gomez-92/BioSoft/docs/manual-de-usuario.docx

# BioSoft

Manual de usuario — sistema de exposición controlada a campos electromagnéticos de frecuencia extremadamente baja para experimentación con animales de laboratorio.

Destinatario: operador y personal técnico del equipo · Versión 2, septiembre de 2026 · Estado: equipo en desarrollo

El presente documento describe la operación del sistema BioSoft: su arquitectura, el cableado de sus componentes, el procedimiento de configuración y ejecución de una exposición, la interpretación de la información que presenta la interfaz y las acciones recomendadas ante condiciones anómalas.

Está dirigido a dos lectores. El operador encontrará en las secciones 5 a 16 lo necesario para conducir un experimento sin conocimientos de programación. El personal técnico que deba abrir el gabinete, verificar una conexión o reemplazar un componente encontrará en las secciones 3 y 4 la descripción completa del cableado, con la asignación de cada pin y un procedimiento de comprobación. En ambos casos resulta indispensable comprender qué magnitudes mide el equipo y bajo qué criterios interrumpe la exposición, dado que de ello depende la validez de los resultados experimentales.

Advertencia preliminar

BioSoft se encuentra en desarrollo. La sección 15 enumera los aspectos que aún no están calibrados, montados o accesibles desde la interfaz. Su lectura es obligatoria antes de emplear el equipo con animales, puesto que condiciona qué diseños experimentales son válidos en el estado actual.

# 1. Objeto del equipo

BioSoft expone una muestra de animales de laboratorio a un campo electromagnético de frecuencia extremadamente baja (ELF) de intensidad y frecuencia controladas, sostenido durante un tiempo definido, mientras verifica de forma continua que las condiciones de la exposición se mantengan dentro de los márgenes admitidos por el protocolo experimental.

Sus funciones son tres, y conviene distinguirlas:

1. Generación del campo: una señal senoidal de la frecuencia seleccionada, con la intensidad de consigna, aplicada sobre hasta cuatro bobinas.
2. Medición en tiempo real de la intensidad de campo, la temperatura y la corriente.
3. Interrupción de la exposición cuando corresponde: por cumplimiento de la duración programada, por detección de una condición peligrosa o por decisión del operador.

La tercera función es la que justifica el sistema. La generación de un campo es un problema resuelto; lo que un experimento con animales exige es que la decisión de detener la exposición no dependa de la presencia de una persona.

## Los dos grupos experimentales

El diseño experimental requiere un grupo tratado y un grupo control. El equipo lo resuelve mediante dos modos de experimento:

Campo X — Las cuatro bobinas contribuyen en fase. Es la condición de exposición.

Campo nulo — Dos de las bobinas reciben la señal invertida 180°, de modo que los campos se cancelan. Los animales del grupo control quedan sometidos al mismo ruido, vibración y temperatura del equipo en funcionamiento, pero sin campo neto.

El campo nulo es lo que hace comparable al grupo control. Un control obtenido apagando el equipo mediría el efecto de permanecer en un recinto distinto, no el efecto del campo.

# 2. Arquitectura del sistema

El sistema está compuesto por dos placas de propósito distinto, unidas por un enlace serie, más los transductores, actuadores y la etapa de potencia que excita las bobinas.

Componente | Función
Interfaz hombre-máquina (HMI) | Placa ESP32 con pantalla táctil de 2,8". Presenta el estado, permite configurar el experimento y publica telemetría por WiFi.
Placa de control | Arduino Mega 2560. Excita las bobinas, lee los sensores y decide cuándo interrumpir la exposición.
Bobinas (hasta 4) | Generan el campo. Se agrupan en dos pares de fase: 1-3 (fija) y 2-4 (invertible).
Sensores | Un magnetómetro, un termómetro y hasta cuatro sensores de corriente.
Etapa de potencia | Acondiciona la señal senoidal, la invierte para el campo nulo, le aplica la amplitud y la entrega a las bobinas.
Interruptor general | Relé que corta la alimentación de toda la etapa de potencia.
Pulsador de emergencia | Corte físico inmediato del experimento en curso.
Tarjeta SD | Archivo de configuración del equipo (sección 14).

La autoridad sobre la seguridad reside en la placa de control, no en la interfaz. Si la pantalla se bloquea o se desconecta, la placa de control continúa vigilando y conserva la capacidad de cortar. La interfaz refleja y retransmite el estado; no lo decide.

Esta separación tiene una consecuencia operativa: cuando el enlace entre ambas placas se interrumpe, la interfaz vuelve a la pantalla de inicio, pero un experimento en curso no se detiene por ese motivo. La placa de control lo lleva a término, lo corta por sus propias reglas o responde al pulsador de emergencia, todo ello sin necesidad de la pantalla.

# 3. Cableado del sistema

Esta sección documenta cómo está conectado el sistema, pin por pin, tal como lo configura el firmware vigente. Su propósito es que quien abra el gabinete pueda identificar cada conexión, comprobarla contra esta referencia y reponerla si fue desconectada. Los números de pin son los serigrafiados en cada placa; las direcciones I2C son las que el firmware espera encontrar en el bus.

Alcance

Se documenta aquí lo que las placas de control e interfaz entregan y reciben: señales lógicas, buses y transductores. La etapa de potencia (amplificación, inversor, filtrado y alimentación de las bobinas) constituye una frontera cuyo diseño eléctrico se describe en docs/coil-excitation.md y cuyo montaje está pendiente (sección 15). Las bobinas están caracterizadas en un trabajo previo cuyos datos no se incorporan en este manual.

## 3.1 Vista general

┌───────────────────────────┐ enlace serie 9600 8N1 ┌───────────────────────────────┐
│ HMI · ESP32 (JC2432W328C) │ │ CONTROL · Arduino Mega 2560 │
│ │ GPIO22 (TX2) ──► RX1 (19) │ │
│ pantalla ST7789 (HSPI) │ GPIO35 (RX2) ◄── TX1 (18) │ I2C SDA 20 / SCL 21 │
│ táctil CST816S (I2C) │ GND ───────────── GND │ ├─ MLX90393 0x0C campo │
│ ranura SD (VSPI) │ │ ├─ ADS1115 0x48 corriente│
│ WiFi → MQTT (telemetría) │ │ └─ ADS1115 0x49 corriente│
└───────────────────────────┘ │ OneWire pin 2 ─ DS18B20 TEMP1 │
│ SPI 50/51/52 + CS 5 ─ AD9833 │
│ A0 ─ magnetómetro simulado │
┌────────────────────────────────────────────────────┐ │ │
│ ETAPA DE POTENCIA (fuera del firmware) │ │ PWM 44/45/46/6 ─► intensidad │
│ │◄─┤ EN 23/24/25/26 ─► habilitar │
│ senoidal ─► directa ─────────────► bobinas 1 y 3 │◄─┤ 22 ─► selector de modo (mux) │
│ └► inversor ─► mux ─────► bobinas 2 y 4 │◄─┤ 3 ─► relé general (act. bajo)│
│ PWM ─► filtro RC ─► nivel DC ─► amplitud │ │ 4 ◄─ pulsador de emergencia │
└────────────────────────────────────────────────────┘ └───────────────────────────────┘

Figura 1. Diagrama de bloques del sistema con los pines que utiliza cada interfaz.

## 3.2 Placa de control: asignación de pines

Tabla completa de los pines del Mega 2560 que el firmware configura. «Sentido» se indica desde el punto de vista de la placa.

Pin | Función | Sentido | Observaciones
2 | Bus OneWire — termómetro DS18B20 (TEMP1) | bidireccional | Requiere resistencia de pull-up de 4,7 kΩ entre la línea de datos y +5 V. Solo se atiende el sensor con código ROM 28 3F E5 57 04 E1 3D ED.
3 | Relé del interruptor general | salida | Activo en alto: HIGH = relé cerrado = etapa de potencia habilitada. LOW, pin desconectado o placa sin alimentación = relé abierto. El driver del relé lleva pull-down en su entrada. Al arrancar queda en LOW (abierto).
4 | Pulsador de emergencia | entrada | Pull-up interno activado: el pulsador conecta el pin a GND al presionarse. Contacto normalmente abierto. Antirrebote de 30 ms por software.
5 | FSYNC (chip select) del generador AD9833 | salida | Junto con el bus SPI de hardware (pines 50-52).
6 | PWM de intensidad — bobina 4 (BOB4) | salida | Timer4, 3906 Hz. Asignación provisoria: confirmar contra el ruteo de la placa.
18 | TX1 — enlace serie hacia la HMI | salida | Va al GPIO35 (RX2) del ESP32. Ver 3.3.
19 | RX1 — enlace serie desde la HMI | entrada | Viene del GPIO22 (TX2) del ESP32.
20 | SDA — bus I2C | bidireccional | Magnetómetro MLX90393 y módulos ADS1115. Pull-ups provistos por los módulos.
21 | SCL — bus I2C | salida | Ídem.
22 | Selector de modo de experimento (mux de fase) | salida | HIGH = campo nulo, LOW = campo X. La polaridad está fijada en firmware como provisoria hasta confirmar el cableado del multiplexor.
23 | Habilitación — bobina 1 (BOB1) | salida | Activo en alto: HIGH = bobina habilitada; LOW o desconectado = cortada. Entrada digital a la etapa de estado sólido, con pull-down del lado de la etapa.
24 | Habilitación — bobina 2 (BOB2) | salida | Ídem.
25 | Habilitación — bobina 3 (BOB3) | salida | Ídem. Canal declarado, no registrado por defecto.
26 | Habilitación — bobina 4 (BOB4) | salida | Ídem. Canal declarado, no registrado por defecto.
44 | PWM de intensidad — bobina 1 (BOB1) | salida | Timer5, 3906 Hz, 8 bits.
45 | PWM de intensidad — bobina 2 (BOB2) | salida | Timer5, 3906 Hz.
46 | PWM de intensidad — bobina 3 (BOB3) | salida | Timer5, 3906 Hz.
50 | MISO — bus SPI | entrada | No utilizado por el AD9833 (solo escritura), pero forma parte del bus.
51 | MOSI — bus SPI (SDATA del AD9833) | salida
52 | SCK — bus SPI (SCLK del AD9833) | salida
A0 | Magnetómetro simulado (tensión analógica) | entrada | 0–5 V se mapean linealmente a 0–3 mT. Solo para banco; si queda sin conectar, la lectura es ruido.
USB | Consola de depuración | — | 115200 baudios. Es la vía de diagnóstico de la sección 4.

Los pines 2, 3 y 5 comparten el Timer3 y, por estar ocupados, dejan ese temporizador fuera del uso como PWM. Los pines 4 y 13 (Timer0) y 9 y 10 (Timer2) están excluidos deliberadamente del PWM de intensidad: el primero es la base de tiempo de millis() y de todas las tareas periódicas del firmware; el segundo tiene una tabla de divisores distinta. De ahí que los cuatro canales de intensidad se ubiquen en Timer5 (44, 45, 46) y Timer4 (6).

## 3.3 Enlace serie entre placas

Las dos placas se comunican por un UART de hardware a 9600 baudios, 8N1, con un protocolo de tramas propio (STX, longitud, JSON, CRC-8, ETX). La conexión es cruzada y requiere masa común:

ESP32 (HMI) | Mega 2560 (control)
GPIO22 — TX2 | pin 19 — RX1
GPIO35 — RX2 | pin 18 — TX1
GND | GND

Niveles lógicos

El Mega 2560 trabaja a 5 V y el ESP32 a 3,3 V. La rama TX1 (Mega) → GPIO35 (ESP32) entrega 5 V a una entrada de 3,3 V y debe pasar por un adaptador de nivel o un divisor resistivo. La rama inversa (3,3 V hacia una entrada del Mega) es directa. El firmware no puede verificar la presencia de ese adaptador; forma parte de la comprobación física de la sección 4.

La vitalidad del enlace se comprueba con un intercambio periódico ping/pong cada 2 s. Mientras no haya respuesta, la interfaz permanece en la pantalla de inicio.

## 3.4 Bus I2C de la placa de control

Tres dispositivos comparten el bus (SDA 20, SCL 21). Al arrancar, el firmware recorre las 127 direcciones posibles y registra en la consola cuáles responden, lo que permite distinguir un bus muerto (cableado o alimentación) de un dispositivo en una dirección distinta de la esperada.

Dirección | Dispositivo | Observaciones
0x0C | MLX90393 — magnetómetro (CEM1) | Dirección por defecto del módulo (pines de dirección a masa). Es un dispositivo de 3,3 V: alimentar según lo que admita el módulo utilizado.
0x48 | ADS1115 n.° 1 — corriente, canales SCT013-1 y SCT013-2 | Pin ADDR a GND.
0x49 | ADS1115 n.° 2 — corriente, canales SCT013-3 y SCT013-4 | Pin ADDR a VDD. Declarado en firmware; no existe físicamente todavía.

## 3.5 Sensores

Magnetómetro (CEM1). Un único MLX90393 por I2C. Es el sensor que cierra el lazo de intensidad, por lo que su posición respecto de las bobinas forma parte de la calibración: si se desplaza, los factores de corrección dejan de ser válidos. El firmware conserva un segundo magnetómetro simulado, que lee una tensión en A0, y el archivo de configuración decide cuál de los dos está activo. El simulado no guarda relación física con el campo real y solo sirve para ensayar el firmware en banco.

Termómetro (TEMP1). Un DS18B20 sobre bus OneWire en el pin 2, alimentado a 5 V, con pull-up de 4,7 kΩ en la línea de datos. El firmware direcciona el sensor por su código ROM de 64 bits; si se reemplaza la unidad física por otra, la dirección compilada no coincidirá y la lectura será −127 °C, que el firmware descarta como inválida sin indicar por qué. Reemplazar el sensor implica actualizar TEMP1_ADDRESS en SoftMega2560.ino.

Corriente (SCT013-1 a 4). Transformadores de corriente SCT-013 leídos por conversores ADS1115 en modo diferencial. Cada ADS1115 ofrece solo dos pares diferenciales: el canal 0 corresponde a AIN0–AIN1 y el canal 1 a AIN2–AIN3. Por ello los cuatro canales del gabinete requieren dos módulos. Solo SCT013-1 (módulo 0x48, canal 0) está cableado y habilitado por defecto. La frecuencia de muestreo y la ganancia son registros del módulo, comunes a sus dos canales.

## 3.6 Cadena de excitación de las bobinas

La forma de onda y la amplitud viajan por caminos separados y se combinan en la etapa de potencia:

┌─► directa ─────────────────────► bobinas 1 y 3 (grupo fijo)
AD9833 ──► senoidal ────┤
(SPI, CS 5) └─► inversor (op-amp) ──┐
├─ mux ──► bobinas 2 y 4 (invertible)
(directa) ──────────────┘ ▲
│
pin 22 ── selector de modo

pin 44/45/46/6 ──► PWM 3906 Hz ──► filtro RC ──► nivel DC ──► amplitud de la senoidal
pin 23/24/25/26 ──► habilitación individual de cada bobina
pin 3 ──► relé general ──► alimentación de toda la etapa (conector GND / VDD / enable)

Figura 2. Cadena de señal desde la placa de control hasta las bobinas.

- El AD9833 produce una única senoidal de bajo nivel con componente continua, a la frecuencia del experimento. No es apta para atacar una bobina directamente y requiere acondicionamiento (centrado y ganancia).
- La inversión de fase para el campo nulo es analógica (op-amp inversor + multiplexor), no por software. Se descartó un segundo generador con fase programada porque dos osciladores independientes derivan entre sí y la cancelación se perdería a los pocos minutos sin síntoma alguno (docs/adr/001-inversion-de-fase.md).
- Los grupos de fase son alternados (1-3 y 2-4), no contiguos. De este modo, con solo dos bobinas consecutivas montadas (BOB1 y BOB2, el registro por defecto) ya es posible ejercitar ambos modos.
- El PWM a 3906 Hz, filtrado a un nivel de continua, fija la amplitud de la senoidal. El firmware nunca trocea la senoidal con el PWM: la bobina recibe una señal continua cuya amplitud es la variable de control.
- La habilitación por bobina y el relé general son cortes independientes: el primero decide qué bobinas participan, el segundo corta toda la etapa.

## 3.7 Interfaz HMI: placa ESP32 y periféricos

La interfaz es una placa integrada de la familia «CYD» (2,8", 240×320). Existen dos revisiones incompatibles y el firmware debe compilarse para la que esté instalada:

Revisión | Identificación | Panel | Táctil
ESP32-2432S028R | Un solo conector micro-USB | ILI9341 | Resistivo XPT2046, por SPI propio (VSPI: CLK 25, MOSI 32, MISO 39, CS 33, IRQ 36)
JC2432W328C (Guition) — instalada | micro-USB + USB-C; modelo impreso al dorso | ST7789 (requiere inversión de color) | Capacitivo CST816S, por I2C (SDA 33, SCL 32, RST 25, INT 21, dirección 0x15)

Ambos táctiles ocupan los mismos GPIO, de modo que no es posible distinguirlos por software. Con la configuración de la revisión R en una placa C los colores aparecen invertidos y se registra un toque permanente en una esquina. El cambio de placa exige modificar conjuntamente TOUCH_KIND en display.hpp y TFT_INVERSION_ON en platformio.ini.

GPIO | Función | Bus | Observaciones
2 | TFT — DC (datos/comando) | HSPI
12 | TFT — MISO | HSPI
13 | TFT — MOSI | HSPI
14 | TFT — SCLK | HSPI | 55 MHz.
15 | TFT — CS | HSPI
21 | Táctil — INT | — | No se utiliza (el táctil se lee por sondeo), pero el CST816S maneja la línea: no debe usarse para otra función.
27 | TFT — retroiluminación | — | En la revisión R era el GPIO21 y el 27 quedaba libre para el enlace serie; en la C el 27 es la retroiluminación.
22 | UART2 — TX (hacia RX1 del Mega) | UART2
35 | UART2 — RX (desde TX1 del Mega) | UART2 | GPIO solo de entrada. Entrada de 3,3 V: ver 3.3.
32 | Táctil — SCL | I2C | CST816S en 0x15.
33 | Táctil — SDA | I2C
25 | Táctil — RST | —
5 | Ranura SD — CS | VSPI
18 | Ranura SD — SCLK | VSPI | La SD no comparte el bus de la pantalla.
19 | Ranura SD — MISO | VSPI
23 | Ranura SD — MOSI | VSPI
USB | Consola de depuración | — | 115200 baudios.

La conectividad remota (WiFi y MQTT sobre TLS) no requiere cableado: las credenciales residen en esp32/include/secrets.h, un archivo excluido del repositorio que debe crearse a partir de secrets.example.h antes de compilar.

## 3.8 Interruptor general y pulsador

El interruptor general es un relé mecánico gobernado por el pin 3 de la placa de control, con lógica activa en bajo. Del lado de la potencia se presenta como un conector de tres contactos (GND, VDD, habilitación) que corta la alimentación de toda la etapa. El relé incorpora una protección por software que ignora cambios de estado separados por menos de 200 ms, con el fin de no maltratar el contacto mecánico.

El pulsador de emergencia es un contacto normalmente abierto entre el pin 4 y GND, con pull-up interno. Se detecta por flanco, con antirrebote de 30 ms, y solo tiene efecto durante un experimento en curso (sección 11).

# 4. Verificación del cableado

Procedimiento para comprobar el estado de las conexiones cuando se abre el gabinete, se sospecha de un contacto defectuoso o se reemplaza un componente. Consta de una inspección sin tensión y de una verificación con el equipo encendido, apoyada en la consola de depuración de cada placa. Ambas placas emiten un registro por su puerto USB a 115200 baudios que puede leerse con cualquier monitor serie.

## 4.1 Inspección sin tensión

4. Masa común. Continuidad entre el GND del Mega, el GND del ESP32 y el GND de la etapa de potencia.
5. Enlace serie. Continuidad pin 18 (Mega) → adaptador de nivel → GPIO35 (ESP32); y GPIO22 (ESP32) → pin 19 (Mega). Confirmar que las líneas están cruzadas (TX con RX) y no en paralelo.
6. Bus I2C. Continuidad de SDA (pin 20) y SCL (pin 21) hasta cada módulo. Verificar el pin ADDR de cada ADS1115: a GND en el módulo 0x48, a VDD en el 0x49.
7. Termómetro. Línea de datos al pin 2, resistencia de 4,7 kΩ entre datos y +5 V, alimentación 5 V y GND.
8. AD9833. SDATA al pin 51, SCLK al pin 52, FSYNC al pin 5, alimentación y GND.
9. Salidas hacia la etapa de potencia. PWM (44, 45, 46, 6), habilitaciones (23, 24, 25, 26), selector de modo (22) y relé (3), cada una en su entrada correspondiente. Un PWM conectado a la habilitación de otra bobina, o viceversa, no genera error alguno en el firmware.
10. Pulsador. Continuidad entre pin 4 y GND únicamente con el pulsador accionado.
11. Magnetómetro. Fijación mecánica en la posición registrada en la calibración.

## 4.2 Verificación con el equipo encendido

Con el monitor serie conectado al Mega, la secuencia de arranque informa el estado de cada bus. Lo que debe observarse:

Registro en consola | Significado | Si no aparece
[I2C] Dispositivo encontrado en 0xC, 0x48 (y 0x49 si existe) | El bus I2C está vivo y cada módulo responde en su dirección | «Ningún dispositivo respondió» indica cableado, alimentación o pull-ups; una dirección distinta indica el pin ADDR mal conectado
[MLX90393] begin_I2C addr=0xC seguido de OK | El magnetómetro inicializó | Revisar alimentación del módulo; el bus puede estar vivo y el sensor no
Lecturas de TEMP1 con valores plausibles | El DS18B20 responde y su código ROM coincide | Sin lecturas: revisar el pull-up; si el sensor fue reemplazado, actualizar el código ROM en el firmware
[CURRENT] sin indicación de módulo ausente | El ADS1115 contestó y el canal quedó habilitado | Un módulo que no responde deja su canal deshabilitado sin bloquear el arranque; revisar dirección y alimentación
Intercambio ping/pong con la HMI («conectado!») | El enlace serie funciona en ambos sentidos | Solo un sentido funciona si las líneas están al revés; ningún sentido funciona si falta la masa común o el adaptador de nivel

Con el monitor conectado al ESP32, deben observarse la inicialización del táctil ([TOUCH] CST816S inicializado), el montaje de la tarjeta SD y el resultado de la lectura de /biosoft/config.json ([CONFIG]). El mensaje [SD] Continuando sin tarjeta SD no constituye un error si no se insertó tarjeta.

Desde la pantalla, la comprobación mínima es que la interfaz abandone la pantalla de inicio y muestre Principal: ello exige que el enlace serie esté funcionando en ambos sentidos.

## 4.3 Verificación de las salidas hacia las bobinas

Con osciloscopio y un experimento en curso a baja intensidad:

- En la salida del AD9833, una senoidal de la frecuencia configurada, de bajo nivel y con componente continua.
- En cada pin PWM habilitado, una onda rectangular de 3906 Hz cuyo ciclo de trabajo varía lentamente mientras el regulador lleva el campo a la consigna. Un ciclo de trabajo fijo en 100 % indica que esa bobina no alcanza la consigna (ver «recorte» en la sección 16).
- En el pin 22, nivel LOW en modo campo X y HIGH en modo campo nulo. En la etapa de potencia, la señal que llega a las bobinas 2 y 4 debe estar en fase con la de 1 y 3 en campo X y en contrafase exacta en campo nulo.
- En el pin 3, nivel LOW mientras el experimento corre y HIGH en reposo.

Sobre el campo nulo

La cancelación debe verificarse con el magnetómetro, no inferirse del nivel del pin 22: el selector de modo indica lo que el firmware pidió, no lo que la etapa de potencia entregó. Mientras el inversor y el multiplexor no estén montados (sección 15), el modo campo nulo no cancela nada.

## 4.4 Alimentación

El Mega 2560 opera con lógica de 5 V y el ESP32 con 3,3 V; el magnetómetro es un dispositivo de 3,3 V y los módulos ADS1115 y el DS18B20 admiten 5 V. El dimensionamiento de la fuente de la etapa de potencia depende de las bobinas reales y no se encuentra documentado en este manual (ver docs/coil-excitation.md, §8).

# 5. Preparación previa al encendido

12. Bobinas conectadas y montadas en su posición.
13. Magnetómetro en su posición registrada. Si fue desplazado desde la última calibración, los valores de intensidad no son confiables.
14. Termómetro en contacto con el elemento cuya temperatura se desea vigilar.
15. Tarjeta SD insertada, si se emplearán parámetros propios.
16. Muestra ubicada.
17. Modo de experimento correcto para la tanda que se ejecutará. En el estado actual se define en el archivo de configuración, no en la pantalla (sección 15).

# 6. Encendido y pantallas

Al energizar el equipo se presenta la pantalla de inicio durante algunos segundos, mientras la interfaz arranca y establece contacto con la placa de control. A continuación pasa automáticamente a la pantalla Principal.

Pantalla | Condición de aparición
Inicio | Al encender, y ante la pérdida de contacto con la placa de control.
Principal | Estado de reposo. Muestra la configuración cargada.
Configuración | Al pulsar Configuración.
Espera | Mientras el equipo inicia o detiene un experimento.
En curso | Durante la exposición.
Resultado | Al finalizar un experimento, cualquiera sea el motivo, y también cuando el equipo se niega a iniciarlo (sección 8).

No es posible navegar libremente entre pantallas: la que se muestra refleja el estado real del equipo. Durante un experimento la pantalla es «En curso» y solo puede abandonarse deteniendo el experimento.

## Pantalla Principal

Presenta los seis parámetros con los que se ejecutará el próximo experimento, el modo de exposición (campo X o campo nulo) y dos botones: Iniciar y Configuración. Se recomienda revisarla antes de cada tanda: constituye el resumen de lo que está a punto de ocurrir.

# 7. Configuración de un experimento

La pantalla Configuración ofrece siete listas desplegables. Guardar aplica los cambios y regresa a Principal; Volver sale sin aplicar modificaciones. La pantalla no avisa si hay cambios sin guardar: al salir con Volver se descartan sin confirmación.

Parámetro | Definición
Intensidad de campo | Consigna, en mT. El equipo regula en lazo cerrado para sostenerla.
Frecuencia | Frecuencia de la señal senoidal, en Hz.
Duración | Tiempo de exposición. Al cumplirse, el equipo corta por sí mismo.
Tolerancia de campo | Desviación admisible de la intensidad medida respecto de la consigna antes de considerarse anormal.
Rango de temperatura normal | Franja esperada. Salir de ella genera una alerta.
Rango de temperatura crítica | Franja límite. Salir de ella puede interrumpir el experimento.
Modo de exposición | Campo X (condición de exposición) o campo nulo (grupo control). Ver más abajo.

## El modo de exposición

La lista ofrece exactamente dos entradas, campo X y campo nulo, y no puede modificarse desde la tarjeta SD: son la condición experimental, no un valor que el operador calibre. El valor inicial es siempre campo X; un campo nulo accidental sería indistinguible de un experimento normal. El modo se elige antes de iniciar y no puede cambiarse con el experimento en curso.

En campo nulo el equipo excita las bobinas con la misma corriente que usaría para la intensidad elegida, de modo que el ruido, la vibración y el calor sean los mismos que en el grupo tratado, pero la consigna del campo neto es cero. Como el campo neto es cercano a cero, no hay una lectura contra la cual regular: el equipo aplica el ciclo de trabajo medido previamente en el banco para esa intensidad y esa frecuencia (el «mapa», sección 14) y no lo corrige durante la exposición.

Campo nulo exige mapa

Si el mapa no tiene un punto para la intensidad y la frecuencia elegidas, el equipo se niega a iniciar en campo nulo y lo informa en la pantalla Resultado (sección 8). No improvisa un valor: un control mal excitado invalidaría la comparación sin dar síntoma alguno.

## Los dos rangos de temperatura

Ambos rangos cumplen funciones distintas:

- Una lectura fuera del rango normal pero dentro del crítico se registra como alerta y el experimento continúa. Expresa una desviación respecto de lo esperado.
- Una lectura fuera del rango crítico expresa una condición peligrosa. Si persiste lo suficiente, el experimento se interrumpe.

Por qué no se corta de inmediato

Que una lectura crítica aislada no interrumpa el experimento es deliberado: una única lectura anómala puede deberse a ruido eléctrico, y abortar por ese motivo invalidaría experimentos válidos. El equipo exige que la condición persista antes de cortar.

## La tolerancia de campo

Además de definir cuándo la intensidad se considera anormal, de la tolerancia se deriva el límite crítico de campo, aplicando un margen fijo del 25 % sobre la franja elegida. Una tolerancia del 5 % define una franja normal de ±5 % y una crítica de ±6,25 %.

En campo nulo la tolerancia sigue siendo un porcentaje de la intensidad elegida, pero la franja se centra en cero y no en la intensidad: con 1 mT y una tolerancia del 5 %, un campo residual de hasta ±0,05 mT se considera normal.

# 8. Inicio de un experimento

Desde Principal, botón Iniciar.

La pantalla pasa a Espera («Iniciando…») mientras la placa de control recibe los parámetros, arranca el generador, habilita las bobinas y cierra el interruptor general. Cuando la placa de control confirma que el experimento está en curso, la pantalla pasa automáticamente a En curso.

Si la placa de control no confirma el arranque, la pantalla de Espera abandona el intento a los pocos segundos y regresa a Principal. El regreso a Principal significa que el experimento no comenzó, no que comenzó y falló. Cuando la placa de control sí recibió la orden pero se negó a ejecutarla, el motivo se muestra en la pantalla Resultado (ver «Cuando el equipo se niega a iniciar»).

## Cómo se mide el campo

El campo magnético no se lee como una instantánea: la señal de las bobinas es alterna (de 1 a 100 Hz) y una sola lectura depende del punto de la onda en que cae. El equipo toma grupos de 10 muestras repartidas a lo largo de uno o varios períodos (a frecuencias altas el sensor no da para 10 muestras en uno solo), calcula el valor eficaz (RMS) de la componente a la frecuencia del experimento y actualiza el valor mostrado cada 2 segundos aproximadamente, promediando decenas de grupos. Repartir las muestras así hace que las distorsiones de la señal (armónicos) casi no influyan en el valor; el costo es que el valor tarda esos 2 segundos en aparecer tras el inicio.

El campo magnético terrestre y cualquier objeto cercano producen una componente continua, que este cálculo deja fuera por construcción: no hay que medir ni descontar el ambiente antes de empezar, y el inicio no demora por ese motivo. Lo que sí se suma a la lectura es cualquier fuente alterna a la misma frecuencia del experimento (por ejemplo, la red eléctrica si se trabaja a 50 o 60 Hz), por lo que conviene mantener el entorno del magnetómetro libre de equipos encendidos.

## Cuando el equipo se niega a iniciar

Hay situaciones en las que iniciar degradado sería peor que no iniciar. El equipo las trata como un experimento terminado antes de empezar: muestra la pantalla Resultado con el panel NO INICIÓ, el motivo y el detalle, y el flujo continúa con normalidad (Volver lleva a Principal).

Titular | Causa | Qué hacer | ¿Repetir?
Sin punto en el mapa | Campo nulo con una intensidad y frecuencia que el mapa no tiene | Medir ese punto en banco y cargarlo en la tarjeta, o elegir otra combinación | No
Balance fuera de tope | El balance del punto supera el máximo permitido de la tarjeta | Revisar el punto del mapa y el tope | No

En estos casos el botón Repetir no aparece: el problema está en la configuración y repetir fallaría igual hasta cambiarla. Estos rechazos no se publican al monitor web: no hubo experimento, y publicarlos crearía una corrida que nunca existió.

## La ventana de asentamiento

Durante los primeros 10 segundos el equipo mide y presenta todas las magnitudes con normalidad, pero no genera alertas ni interrumpe la exposición.

Justificación

En ese lapso el regulador está llevando el campo hasta la consigna, de modo que el sistema se encuentra legítimamente fuera de rango. Sin esa ventana, todo experimento se abortaría a sí mismo al comenzar.

# 9. Supervisión durante el experimento

La pantalla En curso presenta un indicador de salud permanentemente visible y cuatro pestañas.

## Indicador de salud

Estado | Significado
Normal | Sin alertas activas.
Advertencia | Existen alertas, ninguna de tipo crítico. Conviene revisar.
Crítico | Existe al menos una alerta crítica. El experimento puede interrumpirse por sí solo.

## Pestañas

- Objetivos — los parámetros con los que comenzó el experimento, como referencia frente a lo que se mide.
- Progreso — porcentaje y tiempo transcurrido.
- Mediciones — campo (mT), temperatura (°C) y corriente (A), cada una con el instante de su última actualización. La indicación «Sin datos» significa que ese sensor no reporta: puede no estar conectado o estar deshabilitado en la configuración. No equivale a medir cero.
- Alertas — hasta tres alertas, la más reciente en primer lugar.

## Interpretación de las alertas

Cada alerta indica el sensor de origen, el tipo de condición y un contador. El contador es el dato relevante: expresa cuántas veces se acumuló la condición y cuántas se requieren para interrumpir el experimento. Un 2/4 es un aviso; un 3/4 indica que resta una ocurrencia.

Si la misma condición se repite en el mismo sensor, la alerta no se duplica: se actualiza el contador y la alerta pasa al primer lugar. Las tres alertas visibles corresponden por lo tanto a tres condiciones distintas, no a las tres últimas ocurrencias.

## Detención manual

Botón Detener. La pantalla pasa a Espera («Deteniendo…») y luego a Resultado. El experimento queda registrado como detenido por el operador, lo cual, a efectos de los datos, no equivale a un experimento completado.

# 10. Finalización del experimento

Un experimento finaliza de tres maneras, y la pantalla Resultado indica cuál fue. Existe además un cuarto caso, en el que el experimento ni siquiera comenzó:

Resultado | Causa
Exitoso | Se cumplió la duración configurada.
Falla | El equipo interrumpió la exposición por una condición peligrosa sostenida.
Detenido | Lo detuvo una persona, desde la pantalla o mediante el pulsador.
No inició | El equipo se negó a arrancar (mapa o balance; sección 8). No hubo exposición: progreso y tiempo figuran en cero.

En el caso de Falla, el detalle indica qué sensor provocó el corte y con qué contador; por ejemplo, que la temperatura alcanzó el límite de alertas críticas. Esa información debe registrarse: permite determinar si el experimento se perdió por el equipo, por la muestra o por el ambiente.

En el caso de Detenido, el detalle indica de dónde vino la orden: el pulsador de emergencia o el botón de la pantalla. Para el experimento ambos casos son equivalentes, pero no para quien revisa después por qué se interrumpió.

La pantalla muestra el progreso, el tiempo transcurrido y el campo medio (mT), es decir, el promedio de todas las lecturas del campo recibidas durante la exposición. Los tres quedan congelados en el instante de la finalización; no continúan avanzando. Si no llegó ninguna lectura del campo, el campo medio figura como «--», no como cero, para que no se confunda con un campo nulo medido.

Desde Resultado hay dos salidas, y el equipo no abandona esta pantalla por sí mismo, de manera deliberada: el resultado debe poder leerse y anotarse sin apremio.

- Volver regresa a Principal.
- Repetir inicia de inmediato un nuevo experimento con la misma configuración, igual que Iniciar en Principal. Solo aparece cuando el experimento resultó Exitoso o Detenido. Tras una Falla se oculta, porque repetir la misma configuración que acaba de alcanzar un límite muy probablemente volvería a cortar, y la causa debe revisarse antes. Tampoco aparece en No inició (sección 8). Si el enlace con la placa de control está caído, Repetir no hace nada, salvo que la tarjeta haya desactivado la exigencia de esa placa (requireMega, sección 14).

# 11. Parada de emergencia

El pulsador físico interrumpe de inmediato el experimento en curso. Es el camino más corto y no depende de la pantalla ni del enlace serie.

Dos propiedades a tener presentes

Solo actúa durante un experimento en curso. Accionarlo con el equipo en reposo no produce efecto, de manera deliberada: evita que quede registrado el resultado de un experimento que nunca existió.

Deja el experimento en estado Detenido, del mismo modo que el botón de la pantalla.

El interruptor general de potencia es un relé con una protección que ignora cambios de estado separados por menos de 200 ms. En uso normal resulta imperceptible.

# 12. Monitoreo remoto

Con la red WiFi configurada, el equipo publica telemetría a un panel remoto mientras hay un experimento en curso: campo, temperatura, corriente, salud, progreso y tiempo transcurrido.

Tres consideraciones:

- Solo publica durante un experimento. Fuera de una corrida no hay datos, y ello no constituye una falla.
- Es un medio de supervisión, no de control. No es posible iniciar ni detener nada desde el panel remoto.
- La pérdida de WiFi no afecta al experimento. La conectividad se ejecuta en un núcleo aparte y no interfiere con la exposición ni con la vigilancia. Solo se pierden los datos remotos de ese intervalo.

La telemetría viaja cifrada al servidor. El equipo sincroniza su reloj por NTP al conectarse al WiFi y no intenta establecer la conexión segura hasta haberlo hecho, porque todo certificado tiene fechas de validez y un equipo recién encendido cree estar en 1970.

Lo publicado por el equipo se recibe, se almacena y se presenta en el monitor web, descrito en la sección siguiente.

# 13. El monitor web

El monitor web es una página a la que se accede desde cualquier computadora o teléfono con internet, dentro o fuera del laboratorio. Recibe lo que el equipo publica, lo conserva y permite consultar los experimentos anteriores.

Equipo Servidor de Monitor web
(WiFi) telemetría (navegador)

┌────────┐ cifrado ┌──────────┐ ┌──────────────┐
│ ESP32 │───────────▶│ Broker │───────────▶│ En curso │
└────────┘ └──────────┘ guarda │ Historial │
│ y envía │ Detalle │
▼ └──────────────┘
┌──────────┐
│ Base │ histórico de experimentos
└──────────┘

El acceso requiere usuario y contraseña. La dirección y las credenciales las provee quien haya instalado el monitor.

## Pantalla «En curso»

Es la que responde la única pregunta que importa desde lejos: si el experimento marcha bien. Muestra el estado general, el modo de exposición, el avance, el campo y la temperatura medidos junto a sus consignas, una fila por cada bobina montada y las últimas alertas.

Tres comportamientos conviene conocer antes de interpretarla:

- Los valores envejecen a la vista. Bajo cada medición se indica hace cuánto llegó, y pasado un minuto y medio el recuadro se atenúa. Un número atenuado es el último dato conocido, no una medición actual. Sin esta señal, una lectura de hace media hora se vería idéntica a una recién tomada.
- Un valor ausente se muestra como «--», nunca como cero. Durante un experimento, 0 mT es una medición posible.
- Los avisos encabezan la pantalla. Si se pierde la conexión con el servidor, con el broker o entre la interfaz y la placa de control, se anuncia arriba de todo, porque cambia el significado de cuanto figura debajo.

## Pantalla «Historial»

Lista los experimentos registrados, del más reciente al más antiguo, con su fecha, su modo de exposición, cómo terminó y cuántas alertas registró. Puede filtrarse por modo, por motivo de finalización y por tipo de corrida.

Las corridas de prueba no se listan por defecto. Son las hechas con una tarjeta que declara runType: "test" (ver la sección 14) y llevan el distintivo PRUEBA. Para verlas se elige «Solo pruebas» o «Todas» en el filtro de tipo. Una corrida con el distintivo SIN MARCA proviene de un firmware anterior a esta marca: no se sabe si fue un experimento o una prueba, y por eso no se la presenta como ninguno de los dos.

Un experimento puede figurar como «Sin cierre»: son aquellos cuyo mensaje de finalización nunca llegó, por un corte de energía, de red o del propio servidor. Sus mediciones son reales y válidas; lo que se desconoce es cómo terminó.

Un experimento puede llevar el distintivo CON RELAJACIONES: se declaró como experimento, pero corrió con alguna protección apagada (el detector, la vigilancia de la temperatura, el control de intensidad) o con sensores simulados. Sus mediciones pueden ser reales, pero no son las de un experimento en condiciones.

## Pantalla de detalle

Al abrir un experimento se accede a sus consignas, su resultado y los gráficos de campo, temperatura, corriente y ciclo de trabajo por bobina. Sobre las mediciones, líneas verticales punteadas señalan el momento de cada alerta.

El detalle indica también con qué configuración corrió el experimento: un código que identifica el archivo de la tarjeta SD («default» si se usaron los valores de fábrica), y la lista de relajaciones que tenía activas. Dos experimentos con el mismo código corrieron con exactamente los mismos umbrales, factores y ganancias.

Dos criterios de lectura de los gráficos:

- Cada punto muestra su banda de mínimo y máximo, además del promedio. Promediar por sí solo ocultaría los picos, que son justamente los que disparan las alertas y los que se va a buscar.
- Los tramos sin datos se dibujan como huecos. Si el servidor estuvo caído, esos minutos no existen y no se recuperan: unir los extremos con una recta afirmaría algo que nadie midió.

El botón Descargar CSV entrega las mediciones tal como se tomaron, sin promediar, para analizarlas en una planilla.

Alcance del monitor

No controla el experimento, por diseño. No es posible iniciar ni detener un experimento desde la web, ni lo será: hacerlo energizaría las bobinas con animales en el gabinete y sin nadie en la sala, mientras que la parada de emergencia solo auxilia a quien ya está presente. Lo único que la web puede cambiar es la configuración (ver abajo).

Solo hay datos durante un experimento. Fuera de una corrida la pantalla indica que no hay ninguno en curso, y ello no constituye una falla.

El monitor debe permanecer encendido. Es el único que escucha al equipo; lo publicado mientras está detenido se pierde y no se recupera. Aparece luego como un tramo sin mediciones.

## Pantalla «Configuración»

Muestra con qué configuración está funcionando la placa y permite enviarle una nueva. El formulario es el mismo generador de configuración que acompaña al equipo, con las mismas validaciones: no deja enviar un archivo con errores. La red WiFi y el broker no se editan desde acá y la placa conserva los suyos.

Al enviar, la placa recibe la configuración, la valida y la graba en su tarjeta SD, dejando la anterior respaldada como config.prev.json. La pantalla informa el resultado: «Grabada en la placa», o el motivo del rechazo (por ejemplo, un experimento en curso).

Cuándo se aplica

La configuración enviada se aplica en el próximo reinicio de la placa, cualquiera sea su causa, y la placa no pide confirmación en su pantalla. Para aplicarla de inmediato hay que reiniciarla a mano. Un envío se rechaza mientras hay un experimento en curso.

# 14. La tarjeta SD

El equipo lee su archivo de configuración (/biosoft/config.json) de la tarjeta insertada en la interfaz, al encender. Allí residen las opciones que ofrecen las listas de Configuración, la cadencia de cada medición, los parámetros del regulador, qué bobinas están habilitadas y con qué corrección, qué vigila el detector y con qué reglas, y qué se publica remotamente. La parte destinada a la placa de control se le transmite por el enlace serie cada vez que este se establece.

Tres reglas rigen su uso:

18. Sin tarjeta el equipo funciona. Arranca con sus valores de fábrica y lo registra en la consola. No existe un modo «bloqueado por falta de configuración».
19. Un archivo mal formado se descarta por completo, no parcialmente. Se conservan los valores de fábrica. Nunca queda una configuración aplicada a medias.
20. Se lee únicamente al encender. Modificar el archivo con el equipo en marcha no tiene efecto: es necesario reiniciar la interfaz.

## Generador de configuración

El archivo se produce con el generador de configuración (tools/generador-config.html), una página que acompaña al equipo y sirve para armar el config.json sin escribirlo a mano. Presenta un formulario con todas las secciones del archivo —tipo de corrida, opciones de las listas de Configuración, intervalos, control y mapa de intensidad, bobinas, detector, canales de corriente, telemetría, WiFi y broker— y entrega el archivo listo para copiar en la tarjeta. También permite abrir uno existente para modificarlo. Es el mismo formulario que usa la pantalla «Configuración» del monitor remoto (sección 13).

Su ventaja es que valida antes de permitir guardar: rangos, coherencia entre secciones y errores de formato que el equipo no puede advertir por sí mismo. Un valor entero escrito con parte decimal, por ejemplo, se descarta en silencio al leerlo y, en las listas de la pantalla, queda en cero. El generador bloquea la descarga mientras haya errores. Se abre con doble clic, funciona sin conexión y no requiere instalar nada.

## Corridas de prueba

El archivo declara si lo que se corra con esa tarjeta es un experimento o una prueba de banco (clave runType, «Tipo de corrida» en el generador). El valor de fábrica, y el que rige sin tarjeta, es experimento.

Con una tarjeta de prueba la pantalla lo hace evidente de dos maneras: al encender aparece un cartel «Configuración de prueba» que hay que cerrar con ENTENDIDO antes de poder operar, y durante todo el uso queda una franja MODO PRUEBA en el borde superior. Las corridas se publican marcadas, y el monitor web las separa de los experimentos.

Qué hace y qué no hace

Declarar una prueba no apaga ninguna protección. Solo marca las corridas. Si en una prueba se quiere, por ejemplo, desactivar una fuente del detector, eso se configura aparte, en su propia sección del archivo. A la inversa, una tarjeta declarada como experimento puede tener protecciones desactivadas: antes de un experimento real conviene revisar el archivo completo, no solo el tipo de corrida.

La parada de emergencia no puede desactivarse desde la configuración, en ningún tipo de corrida.

## Ajustes de banco

Tres ajustes del archivo existen para trabajar en el banco sin el equipo completo. Los tres vienen de fábrica en su valor más seguro, y el generador avisa cuando se cambian:

Ajuste | De fábrica | Para qué cambiarlo
Exigir la placa de control | Sí | Desmarcado, la pantalla funciona sola: se puede recorrer y «correr» un experimento sin la placa de control conectada. Nada se energiza.
Detector encendido | Sí | Apagado, ninguna alerta puede cortar el experimento. Se sigue midiendo y mostrando.
Sensor de TEMP1 | DS18B20 | sim lee la temperatura de una entrada analógica (0–5 V equivale a 0–50 °C), para provocar un corte con un potenciómetro; none no usa termómetro, para cuando no hay uno conectado.

Con TEMP1 en sim o none el equipo no está midiendo la temperatura del gabinete. Ninguno de estos ajustes es apto para un experimento con animales.

## Escenarios sintéticos

Con el sensor de una fuente en scenario, la placa de control no lee el sensor: calcula la lectura siguiendo un escenario, y esa lectura recorre todo el proceso real. Las alertas, el corte, la pantalla de resultado y el monitor web se comportan como con un sensor de verdad. Sirve para comprobar el equipo completo sin sensores conectados.

El generador de configuración trae escenarios listos: todo normal, temperatura alta, temperatura que sube, campo inestable, campo fuera de rango y sensor de temperatura caído. Los escenarios se adaptan solos a los rangos elegidos en la pantalla Configuración: «temperatura alta» supera el rango crítico elegido, cualquiera sea.

Al usar escenarios

Las bobinas no se energizan mientras el campo no provenga del sensor real (escenario o sim): la pantalla muestra el ciclo de trabajo que se aplicaría, pero no sale a la etapa de potencia.

Todas esas corridas quedan marcadas como PRUEBA, aunque la tarjeta declare corridas normales.

## Sensor sin lecturas

Si un sensor vigilado deja de dar lecturas durante un experimento —se desconecta, se daña o falla su comunicación—, el equipo corta el experimento y la pantalla de resultado indica, por ejemplo, «TEMP1 SIN LECTURAS». De fábrica, el termómetro puede perder tres lecturas seguidas (15 segundos) antes del corte.

El magnetómetro tiene una regla adicional: mientras el equipo regula la intensidad del campo, su falta de lecturas siempre corta, aunque no esté vigilado, porque sin él las bobinas quedarían excitadas sin control. Si el magnetómetro no está conectado, todo experimento con regulación activa se cortará a los pocos segundos de iniciado.

## Mapa de intensidad

La sección control del archivo incluye el mapa, que gobierna cómo se excita la bobina:

- El mapa (control.map). Para cada combinación de intensidad y frecuencia, el ciclo de trabajo que se midió en el banco para lograrla y el balance entre los dos grupos de bobinas. Admite hasta 3 intensidades por 3 frecuencias, es decir, 9 puntos como máximo; cada punto se identifica por el valor de la intensidad y de la frecuencia, no por su posición en la lista, de modo que reordenar o cambiar las opciones de la pantalla no lo desplaza. En campo X el punto es solo el valor de partida del regulador; en campo nulo es lo que se aplica (sección 7). El tope de balance (balanceMax, 0,2 de fábrica) no puede superar 0,5.

Una tarjeta sin mapa vacía el mapa que la placa de control tuviera de una conexión anterior: el campo nulo no corre con puntos que la tarjeta actual no declara. El generador de configuración valida el mapa antes de permitir guardar.

Valores sin verificar

Los puntos del mapa y su balance deben obtenerse con el procedimiento de docs/protocolo-calibracion-intensidad.md; hasta entonces el campo nulo no puede usarse.

Edición del archivo

Se recomienda no editar el archivo a mano y usar el generador de configuración (ver arriba), incluso para quien domina el formato JSON.

# 15. Limitaciones vigentes

Lectura obligatoria antes de usar el equipo con animales

Esta sección no describe defectos a corregir en algún momento futuro: describe el estado real del equipo a la fecha de este manual, y condiciona qué experimentos son válidos.

- El campo no está calibrado. Los parámetros del regulador y los factores de corrección de cada bobina son valores iniciales, no medidos contra las bobinas reales. Un factor de 1,0 significa «aún sin medir», no «medido y sin desvío». Hasta que se ejecute el protocolo de calibración (docs/protocolo-calibracion-intensidad.md), la intensidad indicada no está verificada contra el campo real.
- El modo de experimento se selecciona en Configuración y viaja con la orden de inicio. Por defecto es campo X, nunca campo nulo, porque un campo nulo accidental sería indistinguible de un experimento normal. No puede cambiarse con el experimento en curso: alteraría la condición experimental de animales ya expuestos.
- El mapa y el balance no están medidos en banco. El campo nulo se excita con un ciclo de trabajo que sale del mapa de la tarjeta; sin los puntos medidos, el equipo se niega a iniciar en ese modo. Cuando existan, el balance se fija una vez y no se ajusta durante la exposición: si el desequilibrio entre grupos de bobinas cambia con el calentamiento, el equipo no lo corrige.
- La medición del campo no está verificada en banco. El valor eficaz tiene un piso de ruido (no lee cero ni con las bobinas apagadas), la atenuación del sensor a 100 Hz no está medida, y una fuente alterna a la frecuencia del experimento (la red a 50 o 60 Hz) se suma a la lectura. Además el magnetómetro no informa el signo del campo, de modo que no puede distinguirse de qué lado se desvía.
- Las listas de intensidad y frecuencia admiten 3 entradas cada una a efectos del mapa (9 puntos). Más opciones en la tarjeta no tendrían punto asociado.
- La inversión de fase depende de hardware no montado. El inversor y el multiplexor de la etapa de potencia están diseñados pero no construidos. Hasta entonces, el modo campo nulo no cancela nada, aunque el pin 22 cambie de nivel. Debe verificarse con el magnetómetro antes de confiar en él.
- La vigilancia de campo está desactivada de fábrica. El detector vigila la temperatura; el campo se mide y se muestra, pero por defecto no genera alertas ni corta. Se habilita desde el archivo de configuración, y conviene hacerlo recién con el sensor real montado y calibrado.
- Los umbrales de campo son provisorios. Los valores con los que se decide qué lectura de campo es anormal están copiados de los de temperatura, sin calibrar contra campo real.
- Solo dos bobinas y un canal de corriente están registrados. BOB3, BOB4, el segundo ADS1115 (0x49) y los canales SCT013-2 a 4 están declarados en firmware y listos, pero no montados. La bobina 4 tiene asignado provisoriamente el pin 6.
- La corriente no interrumpe el experimento. Se mide, se muestra y se publica, pero por diseño no es una condición de corte.
- El monitor web no se ha probado con el equipo real. Cuanto se verificó hasta ahora proviene de un simulador que reproduce el formato de los mensajes. La primera corrida con la placa es la que confirmará el resto (secciones 12 y 13).
- La tarjeta puede desactivar la exigencia de la placa de control (requireMega, sección 14). Con ella desmarcada y la placa desconectada, la interfaz «corre» experimentos sin energizar nada. De fábrica está activada; antes de un experimento real conviene revisar que la tarjeta no la haya cambiado.
- Un cambio remoto de configuración no avisa en pantalla. La configuración enviada desde el monitor web se graba en la tarjeta y se aplica al reiniciar; la interfaz no muestra ningún cartel ni ofrece reiniciar. Además, restringir quién puede publicar en el tema de configuración es un paso manual en la consola del servicio de mensajería.

# 16. Diagnóstico de fallas

Síntoma | Interpretación | Acción recomendada
La interfaz regresa por sí sola a la pantalla de Inicio | Se perdió el contacto con la placa de control | Revisar el enlace serie (sección 3.3) y la alimentación de la placa de control
La interfaz nunca abandona la pantalla de Inicio | El enlace serie no funciona en al menos un sentido | Verificar cruce TX/RX, masa común y adaptador de nivel (sección 4.1)
Iniciar deja la pantalla en Espera y regresa a Principal | El experimento no comenzó: la orden no llegó a la placa de control | Revisar el enlace con la placa de control; reintentar
Resultado con panel NO INICIÓ y «Sin punto en el mapa» | Campo nulo con una intensidad o frecuencia que el mapa de la tarjeta no tiene | Cargar el punto medido en el banco, o elegir una combinación mapeada (sección 14)
Resultado con panel NO INICIÓ y «Balance fuera de tope» | El balance del punto supera balanceMax | Revisar el punto y el tope en la tarjeta
Una medición indica «Sin datos» | Ese sensor no reporta | Revisar la conexión (sección 3.5); confirmar que está habilitado en la configuración
La temperatura no reporta pese a estar conectada | El código ROM del DS18B20 no coincide con el compilado | Si el sensor fue reemplazado, actualizar TEMP1_ADDRESS en el firmware
La consola del Mega indica «Ningún dispositivo respondió» en I2C | Bus I2C inoperante | Revisar SDA/SCL, alimentación de los módulos y pull-ups
El campo medido queda muy por debajo de la consigna | El regulador no alcanza la consigna | Buscar avisos de recorte en la consola: una bobina puede carecer de margen. Requiere revisar el hardware o recalibrar
Corta apenas concluye la ventana de asentamiento | Una condición fuera de rango desde el arranque | Consultar el detalle en la pantalla Resultado: indica qué sensor fue
Se modificó el archivo de la SD y no hubo cambios | Se lee solo al encender | Reiniciar la interfaz
La interfaz indica «Continuando sin tarjeta SD» con tarjeta insertada | La tarjeta no responde en el bus VSPI | Reinsertar; comprobar formato FAT32; ensayar con tools/test-sd-esp32
Se cambió la configuración y el panel remoto dejó de mostrar un valor | Se renombró un campo de telemetría | El panel remoto espera los nombres originales: revertirlos o actualizar el panel
Colores invertidos o toque permanente en una esquina | Firmware compilado para la otra revisión de la placa HMI | Ajustar TOUCH_KIND y TFT_INVERSION_ON de manera conjunta (sección 3.7)
El pulsador de emergencia no produce efecto | No hay experimento en curso | Es el comportamiento esperado

# 17. Buenas prácticas

- Revisar la pantalla Principal antes de iniciar. Es el último punto en que se ve la configuración completa antes de exponer animales.
- Registrar el resultado, no solo la finalización. Un experimento interrumpido por falla y uno completado no producen los mismos datos, y el detalle de la pantalla Resultado indica la causa.
- No modificar parámetros entre tandas de una misma serie sin dejar constancia. El equipo no conserva historial: lo único que permanece es lo que registre el operador.
- Verificar el campo nulo antes de cada serie con grupo control. Un control mal cancelado es un grupo tratado sin que nadie lo advierta, y constituye el error más costoso que este equipo puede cometer: invalida la comparación completa sin manifestar síntoma alguno.
- No tocar nada cerca del magnetómetro al pulsar Iniciar. Durante los primeros segundos el equipo mide el campo ambiente para descontarlo; lo que se mueva en ese lapso queda incorporado como si fuera ambiente.
- No dar por válido el campo nulo sin el mapa medido. Cargar el punto de cada combinación de intensidad y frecuencia que se vaya a usar, y verificar el campo residual con el magnetómetro antes de la serie.
- Documentar toda intervención en el cableado. Tras abrir el gabinete, repetir la verificación de la sección 4 y anotar qué se desconectó y qué se repuso; si se movió el magnetómetro, la calibración debe repetirse.
