gomez-92/BioSoft/docs/manual-de-usuario.html

Manual de usuario

# BioSoft

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

Destinatario · operador y personal técnico del equipo Versión · 2, septiembre de 2026 Estado · equipo en desarrollo Fuente · docs/manual-de-usuario.html

### Contenido

1. 1 Objeto del equipo
2. 2 Arquitectura del sistema
3. 3 Cableado del sistema
4. 4 Verificación del cableado
5. 5 Preparación previa al encendido
6. 6 Encendido y pantallas
7. 7 Configuración de un experimento
8. 8 Inicio de un experimento
9. 9 Supervisión durante el experimento
10. 10 Finalización del experimento
11. 11 Parada de emergencia
12. 12 Monitoreo remoto
13. 13 El monitor web
14. 14 La tarjeta SD
15. 15 Limitaciones vigentes
16. 16 Diagnóstico de fallas
17. 17 Buenas prácticas

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

Advertencia preliminar

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

## Sección 1

Objeto del equipo

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

Sus funciones son tres, y conviene distinguirlas:

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

### Los dos grupos experimentales

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

Campo X
Las cuatro bobinas contribuyen en fase. Es la condición de exposición.

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

## Sección 2

Arquitectura del sistema

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

## Sección 3

Cableado del sistema

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

Alcance

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

### 3.1 Vista general

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

Figura 1. Diagrama de bloques del sistema con los pines que utiliza cada interfaz.

### 3.2 Placa de control: asignación de pines

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

### 3.3 Enlace serie entre placas

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

Niveles lógicos

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

### 3.4 Bus I2C de la placa de control

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

### 3.5 Sensores

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

### 3.6 Cadena de excitación de las bobinas

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

Figura 2. Cadena de señal desde la placa de control hasta las bobinas.

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

### 3.7 Interfaz HMI: placa ESP32 y periféricos

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

### 3.8 Interruptor general y pulsador

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

## Sección 4

Verificación del cableado

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

### 4.1 Inspección sin tensión

1. Masa común. Continuidad entre el GND del Mega, el GND del ESP32 y el GND de la etapa de potencia.
2. Enlace serie. Continuidad pin 18 (Mega) → adaptador de nivel → GPIO35 (ESP32); y GPIO22 (ESP32) → pin 19 (Mega). Confirmar que las líneas están cruzadas (TX con RX) y no en paralelo.
3. Bus I2C. Continuidad de SDA (pin 20) y SCL (pin 21) hasta cada módulo. Verificar el pin ADDR de cada ADS1115: a GND en el módulo 0x48, a VDD en el 0x49.
4. Termómetro. Línea de datos al pin 2, resistencia de 4,7 kΩ entre datos y +5 V, alimentación 5 V y GND.
5. AD9833. SDATA al pin 51, SCLK al pin 52, FSYNC al pin 5, alimentación y GND.
6. Salidas hacia la etapa de potencia. PWM (44, 45, 46, 6), habilitaciones (23, 24, 25, 26), selector de modo (22) y relé (3), cada una en su entrada correspondiente. Un PWM conectado a la habilitación de otra bobina, o viceversa, no genera error alguno en el firmware.
7. Pulsador. Continuidad entre pin 4 y GND únicamente con el pulsador accionado.
8. Magnetómetro. Fijación mecánica en la posición registrada en la calibración.

### 4.2 Verificación con el equipo encendido

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

### 4.3 Verificación de las salidas hacia las bobinas

Con osciloscopio y un experimento en curso a baja intensidad:

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

Sobre el campo nulo

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

### 4.4 Alimentación

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

## Sección 5

Preparación previa al encendido

1. Bobinas conectadas y montadas en su posición.
2. Magnetómetro en su posición registrada. Si fue desplazado desde la última calibración, los valores de intensidad no son confiables.
3. Termómetro en contacto con el elemento cuya temperatura se desea vigilar.
4. Tarjeta SD insertada, si se emplearán parámetros propios.
5. Muestra ubicada.
6. Modo de experimento correcto para la tanda que se ejecutará. En el estado actual se define en el archivo de configuración, no en la pantalla (sección 15).

## Sección 6

Encendido y pantallas

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

### Pantalla Principal

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

## Sección 7

Configuración de un experimento

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

### El modo de exposición

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

Campo nulo exige mapa

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

### Los dos rangos de temperatura

Ambos rangos cumplen funciones distintas:

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

Por qué no se corta de inmediato

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

### La tolerancia de campo

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

## Sección 8

Inicio de un experimento

Desde Principal, botón Iniciar.

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

### Cómo se mide el campo

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

### Cuando el equipo se niega a iniciar

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

### La ventana de asentamiento

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

Justificación

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

## Sección 9

Supervisión durante el experimento

La pantalla En curso presenta un indicador de salud permanentemente visible y cuatro pestañas.

### Indicador de salud

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

### Pestañas

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

### Interpretación de las alertas

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

### Detención manual

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

## Sección 10

Finalización del experimento

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

## Sección 11

Parada de emergencia

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

Dos propiedades a tener presentes

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

Deja el experimento en estado Detenido, del mismo modo que el botón de la pantalla.

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

## Sección 12

Monitoreo remoto

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

Tres consideraciones:

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

## Sección 13

El monitor web

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

   Equipo              Servidor de              Monitor web
   (WiFi)              telemetría               (navegador)

  ┌────────┐   cifrado  ┌──────────┐            ┌──────────────┐
  │ ESP32  │───────────▶│  Broker  │───────────▶│   En curso   │
  └────────┘            └──────────┘   guarda   │   Historial  │
                              │        y envía  │   Detalle    │
                              ▼                 └──────────────┘
                        ┌──────────┐
                        │   Base   │  histórico de experimentos
                        └──────────┘

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

### Pantalla «En curso»

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

Tres comportamientos conviene conocer antes de interpretarla:

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

### Pantalla «Historial»

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

### Pantalla de detalle

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

Dos criterios de lectura de los gráficos:

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

Alcance del monitor

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

### Pantalla «Configuración»

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

Cuándo se aplica

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

## Sección 14

La tarjeta SD

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

Tres reglas rigen su uso:

1. Sin tarjeta el equipo funciona. Arranca con sus valores de fábrica y lo registra en la consola. No existe un modo «bloqueado por falta de configuración».
2. Un archivo mal formado se descarta por completo, no parcialmente. Se conservan los valores de fábrica. Nunca queda una configuración aplicada a medias.
3. Se lee únicamente al encender. Modificar el archivo con el equipo en marcha no tiene efecto: es necesario reiniciar la interfaz.

### Generador de configuración

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

### Corridas de prueba

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

Qué hace y qué no hace

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

La parada de emergencia no puede desactivarse desde la configuración, en ningún tipo de corrida.

### Ajustes de banco

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

### Escenarios sintéticos

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

Al usar escenarios

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

Todas esas corridas quedan marcadas como PRUEBA, aunque la tarjeta declare corridas normales.

### Sensor sin lecturas

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

### Mapa de intensidad

La sección control del archivo incluye el mapa, que gobierna cómo se excita la bobina:

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

Valores sin verificar

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

Edición del archivo

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

## Sección 15

Limitaciones vigentes

Lectura obligatoria antes de usar el equipo con animales

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

## Sección 16

Diagnóstico de fallas

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

## Sección 17

Buenas prácticas

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
