gomez-92/BioSoft/(commit log)

2026-08-19 Migracion inicial a PlatformIO (BioSoft)
    Estructura nueva con esp32/ y mega2560/ como proyectos PlatformIO
    independientes, migrados desde los sketches de Arduino IDE SoftEsp32 y
    SoftMega2560. Credenciales de WiFi/MQTT movidas a esp32/include/secrets.h
    (gitignored, con plantilla secrets.example.h). Ambas placas compilan
    (pio run) con las mismas versiones de librerias que estaban instaladas
    en el entorno de Arduino IDE.
2026-08-20 Fix protocolo temp/cem/current data y crash de UB en ESP32; agrega tests nativos del Detector
    - esp32/mysystem.hpp: onCommand esperaba claves genericas ("temp"/"cem"/"curr")
    para temp_data/cem_data/current_data, pero el Mega publica cada sensor con su
    nombre real (ThermometerManager/MagnetometerManager/CurrentSensorsManager::
    publishMeasures). Los widgets de medicion nunca se actualizaban.
    - esp32/systemdata.hpp: SystemData::latestUpdateStr no tenia return en ningun
    branch (UB) - devolvia basura de registro como puntero, causando un
    Guru Meditation Error (StoreProhibited) apenas measureTemperature dejaba de
    ser 0 (es decir, apenas se arreglaba el bug anterior). Confirmado en plac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
    [mysystem.hpp, systemdata.hpp]
2026-08-20 Activa sensor de corriente (SCT013) end-to-end, corrige puntero colgante
    - SoftMega2560.ino: CurrentSensorSct013 era una variable local de setup()
    cuya direccion se guardaba en CurrentSensorsManager (que sobrevive a
    setup()) -> puntero a stack ya liberado. Pasado a asignacion dinamica
    (new), igual que ThermometerDS18B20 y MagnetometerMlx90393.
    - engine.hpp: descomenta la tarea MeasureCurrent en Engine::onStart() (era
    el unico paso que faltaba, protocolo y ESP32 ya estaban listos); agrega
    tracing por Serial en el camino de current_data; corrige conversion
    invalida const Source*->Source* en onFlag.
    - currentmanager.hpp: elimina lectura muerta (variable sin usar) en
    updateAll().
    -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
    [SoftMega2560.ino, currentmanager.hpp, engine.hpp, intervals.hpp]
2026-08-20 Activa corte automatico por tiempo y progreso real en pantalla Running
    - mega2560/engine.hpp: agenda Tasks::Finish al iniciar (estaba comentado).
    Al cumplirse la duracion, encadena _stop(); _reset(); en vez de solo
    _stop() -- decision de alcance: se salta el estado Finished (que el
    ESP32 no consume hoy, pantalla Resultado sin implementar) y vuelve
    directo a Ready, reusando el mismo mecanismo que ya dispara un reset
    manual (ReSendReset en el ESP32 al ver state_data:"ready").
    - esp32/mysystem.hpp: al entrar a Running, fija progress.startTime/
    duration con la misma duracion (ms) que ya se mando en el start --
    antes quedaban siempre en 0 y la barra de progreso nunca avanzaba.
    - esp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
    [engine.hpp, mysystem.hpp, screencontroller.hpp]
2026-08-20 Cablea boton Detener en Running y saca la evaluacion de salud del Mega
    - Boton Detener (ui_TabPageProgressBtnDetener, sin cablear): agrega
    EventName::Stop, RunningController::onStop()/btnRunningDetenerClick, y
    la rama RUNNING+Stop en MySystem::onScreenEvent (mismo patron que el
    Start de PrincipalController).
    - Dos bugs de fondo encontrados al trazar el flujo de Detener, sin los
    cuales el boton quedaba colgado en "Deteniendo...":
    - mega2560/engine.hpp: Commands::Stop solo llamaba a _stop() (deja el
    Engine en State::Finished, que el ESP32 no consume). Encadena
    _reset() igual que Tasks::Finish (corte por tiempo) para volver a
    Ready.
    - esp32/mysystem.hpp: _processState()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
    [engine.hpp, eventsname.hpp, intervals.hpp, mysystem.hpp, runtimestate.hpp, screencontroller.hpp, tasks.hpp]
2026-08-21 Habilita deteccion de flags de temperatura con racha real y corte automatico
    - detector.hpp: agrega racha consecutiva a SourceState (criticalStreak/
    outStreak) para critical/streak -- antes evaluaban un conteo de
    ventana (cuantas muestras "no normales" hay ahora mismo en el buffer),
    no si la condicion se sostiene muestra a muestra. Corrige ademas la
    clasificacion: "critico" es un subconjunto mas severo de "fuera de lo
    normal" (rangos anidados), no una categoria mutuamente excluyente --
    una muestra critica ahora suma a streak/frequency tambien, no los
    corta. frequency sigue basada en la ventana del buffer (inestabilidad
    general, no rachas) y ya no duplica el conteo de las crit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
    [commands.hpp, detector.hpp, engine.hpp, mysystem.hpp]
2026-08-21 Corrige settling time nunca desactivado y ajusta muestreo/logs
    El timer SettlingTime quedaba comentado en onStart(), asi que
    _isSettlingTime nunca volvia a false y el detector no recibia
    muestras durante todo el experimento (sin flags posibles). Tambien
    sensa temperatura cada 5s (antes 25s), espacia el log de RAM libre
    del Mega a cada 10s, y saca del ESP32 los logs de duracion de loop
    y procesos que tapaban el resto de la traza.
    [SoftEsp32.ino, SoftMega2560.ino, engine.hpp, intervals.hpp, mysystem.hpp]
2026-08-21 Muestra las ultimas flags en la tab de Alertas de Running
    El Mega ya mandaba flag_data (source/type/count/limit) por cada evento
    del Detector, pero el ESP32 solo lo logueaba. Ahora SystemData guarda
    hasta 3 alertas (AlertsData::pushAlert), dedupeadas por source+type
    -- una repeticion del mismo source+type actualiza esa entrada con el
    acumulado en vez de duplicarla, y la pasa al frente.
    RunningController vuelca esos slots en los paneles ui_Alert1/2/3 ya
    armados en la UI: icono critico o warning segun el tipo, texto del
    tipo en espanol, source, count/limit y hace cuanto se actualizo. Un
    panel sin alerta en su slot queda oculto -- con 0, 1 o 2 flags activas
    solo se muestran los paneles que cor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
2026-08-21 Evalua la salud del experimento en el ESP32 a partir de las alertas
    El calculo de salud (normal/warning/critical) vivia en el Mega y se
    saco en un refactor anterior, dejando el icono de Estado en Running
    hardcodeado siempre en Normal. Ahora SystemData::evaluateHealth() lo
    calcula del lado ESP32 usando las alertas ya recibidas (sin alertas
    -> normal, alguna critica -> critical, solo streak/frequency ->
    warning), y RunningController refleja el resultado en el label
    ui_HealthEstado y el icono correspondiente.
    Se recalcula en dos disparadores puntuales -- al entrar a Running
    (reset a normal) y en cada flag_data que llega -- en vez de por
    polling; se saco Tasks::UpdateHealth (quedaba redundante)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
    [intervals.hpp, mysystem.hpp, screencontroller.hpp, systemdata.hpp, tasks.hpp]
2026-08-21 Construye y muestra el resultado del experimento en ambas placas
    RuntimeState::setResult() existia en el Mega pero nadie lo llamaba --
    result_data siempre viajaba con reason/description vacios. Ahora
    Engine::_finish() centraliza el cierre del experimento (reemplaza los
    3 _stop()+_reset() sueltos en Tasks::Finish, Commands::Stop y el
    corte por flag de Detector::onFlag) y arma un resultado real antes de
    parar: completed/stopped/critical, con descripcion especifica en el
    caso critico (que source, que tipo de flag, count/limit).
    Del lado ESP32, Commands::ResultData estaba comentado y la pantalla
    Resultado era inalcanzable -- ningun codigo navegaba nunca a
    ScreenType::RESULT. Ahora al llegar res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
2026-08-24 Agrega intervalos y tareas de publicacion periodica a Datacake
    Cadencia de PublishMeasures/PublishStatus separada por tipo de variable
    (mediciones en vivo vs estado general) para poder ajustarlas de forma
    independiente sin tocar codigo. Topics MQTT propios de la ESP32
    documentados aparte del protocolo serie con el Mega.
2026-08-24 Corrige RMS/PWM/Timer, agrega pulsador y CEM simulado, refactoriza config del Detector (mega2560)
    Segun auditoria de contrato por modulo (tablero Trello BioSoft):
    - MOD-006: filtro de offset DC de un solo paso antes de elevar al
    cuadrado en el calculo RMS de corriente (currentsensorsct013.hpp).
    - MOD-010: PWM_PIN movido de A0 (sin timer de hardware en el Mega2560) a
    pin 44 (Timer5/OC5C); parametro `frequency` del constructor, antes sin
    efecto, ahora se aplica realmente via prescaler (pwmdriver.hpp).
    Requiere mover el cable fisico de A0 a pin 44 en la placa.
    - MOD-013: nuevo modulo EmergencyButton (flanco + debounce + pull-up
    opcional) cableado en Engine como disparador de parada de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
    [SoftMega2560.ino, currentsensorsct013.hpp, debugconfig.hpp, detector.hpp, detectorconfigbuilder.hpp, emergencybutton.hpp, engine.hpp, enginestate.hpp]
2026-08-24 Agrega modulo SD, corrige tolerancia de CEM, logs de debug y comentarios (esp32)
    - MOD-020: nuevo modulo generico SdStorage (leer/escribir/agregar/existe/
    borrar archivos, agnostico del contenido) para la ranura SD de la
    ESP32-2432S028 (CYD) -- comparte bus SPI con el TFT (pines 12/13/14),
    CS propio en GPIO 5. Instanciado en SoftEsp32.ino, sin integrar
    todavia a MySystem/Engine (a proposito, prioridad en validar primero
    la funcionalidad critica).
    - MOD-025: lista de tolerancia de CEM en Configuraciones pasada de
    {1%,5%,10%} a {5%,10%}; multiplicador critico/normal (antes 1.25
    hardcodeado inline) centralizado en Sa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
    [SoftEsp32.ino, broker.hpp, configurationoptions.hpp, debugconfig.hpp, display.hpp, mysystem.hpp, screencontroller.hpp, screenmanager.hpp]
2026-08-24 Excluye del repo la carpeta de documentacion/tesis (BioSoft/)
    Nunca estuvo trackeada; se agrega explicitamente a .gitignore para que
    no aparezca como sin trackear en cada git status ni se sume por
    accidente con un add masivo.
2026-08-24 Documenta en CLAUDE.md las decisiones de la ronda de auditoria y correccion
    Corrige la afirmacion de que seriallink.hpp esta duplicado byte a byte
    (ya no lo esta) y describe el patron de logs de debug por macro que
    reemplazo a los Serial.print directos. Deja constancia de decisiones
    que no son obvias leyendo un solo archivo: por que CEM1 usa un sensor
    simulado en vez del driver real, por que PWM_PIN se movio de A0 a 44,
    que SCT013-1 nunca fue pensado como fuente del Detector, y el riesgo
    de conteo hardcodeado en buildDropdown.
2026-08-24 Corrige bugs de auditoria MOD-011 y agrega suites de test host (mega2560)
    Extrae RmsAccumulator (rmscalculator.hpp) del calculo de RMS en
    CurrentSensorSct013. Corrige el gate de la integral lenta en
    FieldController: el paso proporcional y la integral ahora son ramas
    if/else mutuamente excluyentes en la misma llamada, en vez de depender
    de comparar _output contra un _lastOutput que quedaba desincronizado.
    Corrige Relay::begin() para no pasar por open() (bloqueado por el
    blanking de canToggle() en los primeros 200ms de millis()), dejando un
    rele ACTIVE_LOW cerrado al arrancar. Hace pura la interfaz
    IMagnetometerListener::onMagnetometerSample. Guarda con UNIT_TEST el
    acceso a TCCR5B en PwmDrive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
    [currentsensorsct013.hpp, fieldcontroller.hpp, magnetometermanager.hpp, pwmdriver.hpp, relaymanager.hpp, rmscalculator.hpp]
2026-08-25 Corrige notificacion de conexion WiFi centralizada en update() (esp32)
    connectTo() notificaba directo sin sincronizar el flag de update(),
    causando doble aviso en la conexion inicial y aviso repetido en cada
    retry fallido. Ahora update() es el unico punto que compara
    estado+SSID y dispara onWiFiConnected/Disconnected, incluyendo la
    migracion a una red de mayor prioridad sin desconexion previa.
    [wifimanager.hpp]
2026-08-29 Deshabilita temporalmente CEM1 en el Detector para bring-up sin A0 cableado
    Con A0 flotante, MagnetometerVoltageSim genera lecturas fuera de rango que
    disparan un falso flag "critical" y cortan el experimento antes de poder
    probar el enlace serie, las pantallas, la duracion y el boton Detener.
2026-08-29 Corrige fallback de timeout de Busy al detener: vuelve a Ready, no a Running
    El timeout de la pantalla Busy (6s) puede disparar antes de que llegue el
    primer state_data:ready tras un stop (hasta 5s, via Tasks::SendState). El
    fallback llamaba _processState(StateData::Running), que resetea
    progress.startTime/duration y muestra Running de nuevo aunque el Mega ya
    haya terminado y este en Ready sin nada corriendo -- coincide con el patron
    ya documentado en el comentario de _processState (rama Ready). Ahora usa
    _processState(StateData::Ready), igual que el caso analogo de Starting.
    [mysystem.hpp]
2026-08-29 Deshabilita termometro y sensor de corriente para bring-up sin cablear
    El log de bring-up mostro el loop() del Mega colgado indefinidamente en
    MEASURE_CURRENT: CurrentSensorSct013::update() -> Adafruit_ADS1115
    readADC_Differential_*() bloquea esperando un ACK I2C que nunca llega con
    el ADS1115 desconectado (bus flotante, sin pull-ups). Esto explicaba por
    que Tasks::Finish nunca disparaba -- no era un bug de duracion/timer, era
    un cuelgue total del MCU antes de llegar a esa marca.
    De paso, MEASURE_TEMPERATURE mostraba 752ms de bloqueo por ciclo (5s):
    DallasTemperature::requestTemperatures() espera la conversion completa
    siempre, tenga o no sensor real en el bus.
    Ambos managers ya devuelven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
    [SoftMega2560.ino]
2026-08-29 Documenta en CLAUDE.md los hallazgos del bring-up de esta rama
    CEM1 sacado del Detector, el riesgo de cuelgue I2C de termometro/corriente
    sin cablear, y el fix del fallback de timeout de Busy al detener -- para
    que el proximo bring-up parcial no repita el mismo diagnostico desde cero.
2026-08-30 Re-habilita el termometro DS18B20 para bring-up (validado con hardware real)
    Se agrego temporalmente un escaneo del bus 1-Wire para diagnosticar el
    -127 inicial (pull-up faltante en el conector recien soldado, no problema
    de codigo ni de direccion). Resuelto el cableado, se saca el diagnostico:
    el flujo completo lectura->temp_data->Detector->corte por critico ya quedo
    validado con hardware real (2 alertas critical de TEMP1 cortaron el
    experimento correctamente).
    [SoftMega2560.ino]
2026-08-31 Agrega combo temporal de testMode (1-6) para bring-up INT-001
    Permite alternar por software, sin reflashear en el laboratorio, entre
    sensor CEM simulado/real, fuente del Detector on/off y lazo PWM on/off,
    segun las 6 pruebas de la tarjeta Trello "Prueba de integracion --
    Control de intensidad CEM (INT-001)". El ESP32 manda testMode (1-6) en
    el start; la Mega lo decodifica en Engine::_applyTestMode() via el
    helper puro testmoderesolver.hpp (con su propio test nativo). Se agrega
    tambien un log de debug del duty cycle del PWM para los tests con lazo
    de control activo (2,3,5,6).
2026-09-09 Corrige reinit del MLX90393 en caliente y hace continuo el paso P del FieldController
    _applyTestMode() reconstruye magnetometros en cada start, y begin()
    incondicional reseteaba el MLX90393 ya andando (fallaba el segundo begin_I2C
    en banco); ahora solo llama begin() si el sensor no es valido. Se corrige
    tambien la conversion uT->mT que faltaba en el driver real, se reordena
    _applyTestMode() antes de configurar la source CEM1 (si no, la config se
    perdia en silencio), y se reemplaza el paso proporcional discreto del
    FieldController por uno continuo (kp * error) para evitar el rebote de duty
    ante errores chicos (MOD-011). Debug de modulos no relacionados al bring-up
    del campo magnetico queda ap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
    [SoftMega2560.ino, engine.hpp, enginestate.hpp, fieldcontroller.hpp, magnetometermanager.hpp, magnetometermlx90993.hpp, relaymanager.hpp, seriallink.hpp]
2026-09-09 Define el esquema JSON de configuracion en SD (tarjetas 1 y 3)
    Documenta el contrato del archivo /biosoft/config.json que la app externa
    genera, la ESP32 lee y el Mega2560 recibe fragmentado por serie. Cierra el
    relevamiento de datos parametrizables y define la estructura concreta de las
    5 secciones: menus del operador, intervalos de tareas, fuentes del Detector,
    sensores de corriente y telemetria remota.
    Decisiones de contrato:
    - Los defaults compilados nunca desaparecen; el archivo solo pisa las claves
    que trae. Sin SD o con JSON corrupto el sistema arranca igual.
    - La config del Mega no entra en una trama de 256 bytes: se envia fragmentada,
    un frame por unidad logica, cada uno con ac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
2026-09-09 Documenta en CLAUDE.md el contrato de configuracion en SD
    Deja asentado que SdStorage ya tiene definido que va a leer, y las dos reglas
    del contrato que condicionan la implementacion: los defaults compilados
    siempre sobreviven, y la porcion del Mega viaja fragmentada porque no entra en
    una trama de 256 bytes.
    Aclara ademas que Commands::ConfigSource nunca se declaro en commands.hpp
    -- revivirlo no es solo descomentar el handler -- y que _readRule() en cambio
    es codigo vivo que ya parsea la forma exacta que usa el esquema.
2026-09-09 Corrige la frecuencia real del PWM y documenta el contrato de salida a bobinas
    applyFrequency() calculaba la frecuencia como fClk/(N*top), sin el factor 2
    del modo phase correct en que el core de Arduino deja los timers 1/3/4/5. El
    error no era teorico: pedir los 490 Hz del default hacia elegir el divisor 256
    (~122 Hz reales) en vez del 64 que el timer ya traia de fabrica, empeorando en
    silencio una configuracion que estaba bien. El unico sintoma habria sido un
    zumbido mas grave y, con el filtro RC previsto, un rizado mucho mayor sobre la
    amplitud que llega a la bobina.
    Extrae a PwmTiming las dos decisiones puras que preceden a la escritura del
    registro -- seleccion de prescaler y mapeo pin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
    [SoftMega2560.ino, pwmdriver.hpp, test_pwmdriver.cpp]
2026-09-09 Registra en un ADR por que la inversion de fase vuelve a ser analogica
    La decision del 2026-09-09 -- dos AD9833 con fase programada por software --
    no puede sostener el campo nulo: cada modulo trae su propio oscilador de
    25 MHz y, como la salida es fMCLK*FREQREG/2^28, unas pocas ppm de diferencia
    hacen que la fase relativa rote sin parar. A 50 Hz con 50-100 ppm eso es una
    vuelta completa cada 200-400 segundos: el grupo control arrancaria en campo
    nulo y estaria sumando en fase minutos despues, sin que nada lo advierta.
    Vuelve entonces la inversion analogica, pero sin los 2 reles selectores que
    motivaron su descarte en su momento: op-amp inversor mas un multiplexor
    gobernado por un solo GPIO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
2026-09-09 Saca de Engine la decision de que senal reciben las bobinas
    Engine manejaba el SignalGenerator directo en _start()/_stop()/_reset(),
    mezclando la orquestacion del experimento con el detalle de como se excita una
    bobina. CoilExcitationManager toma esa responsabilidad y expone el concepto que
    al experimento le importa: el modo (campo X o campo nulo del grupo control).
    setMode() se rechaza si hay un experimento corriendo. Cambiar de campo a campo
    nulo a mitad de una corrida altera la condicion experimental de animales que ya
    estan expuestos, asi que el modo se elige antes de arrancar y no despues.
    El modo viaja como parametro OPCIONAL del comando start: si no viene, se asume
    campo X. Eso deja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
2026-09-09 Renombra CoilExcitationManager a CoilExcitation
    El sufijo Manager venia de cuando el modulo orquestaba 2 AD9833. Con la
    inversion de fase resuelta en analogico (ADR-001) quedo con un generador y un
    pin, y el nombre paso a ser enganoso: los *Manager de este proyecto
    (MagnetometerManager, ThermometerManager, CurrentSensorsManager) son todos
    contenedores de N cosas homogeneas con addX/xAll, y este no lo es.
    No es solo cosmetica: ya indujo a error al leerlo, confundiendolo con el modulo
    que agrupa el PWM y el enable por bobina (CoilChannel). Se renombra ahora, antes
    de que CoilChannel y la pantalla lo referencien y el cambio cueste mas.
    Lo que justifica al modulo no es gestionar una coleccion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
    [SoftMega2560.ino, coilexcitation.hpp, engine.hpp, signalgenerator.hpp, test_coilexcitation.cpp]
2026-09-09 Colapsa RelayManager en MainPowerSwitch
    RelayManager era un contenedor de hasta 10 reles (addRelay/beginAll/openAll)
    para una cantidad que por diseno siempre fue uno solo: el interruptor general
    de la etapa de potencia. Un manager de N con N=1 fijo es indireccion sin
    concepto -- mismo criterio por el que CoilExcitation dejo de llamarse Manager.
    Lo que si aporta el reemplazo es vocabulario: Engine pide enable()/disable()
    sobre el interruptor general en vez de closeAll()/openAll(), y deja de razonar
    en contactos abiertos y cerrados, que son un detalle del rele y no del
    experimento.
    Relay queda igual: su blanking de 200ms sigue teniendo sentido para un rele
    mecanico real, y sigue aplicando po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
2026-09-09 Documenta el protocolo de calibracion del lazo de intensidad
    Separa dos cosas que se venian mezclando al hablar de calibrar: la ganancia de
    planta K (cuantos mT da una unidad de duty, propiedad fisica del conjunto
    bobina + etapa + posicion del sensor) y el factor por bobina (cuanto mas duty
    necesita cada una para el mismo campo).
    De ahi sale el punto que motiva el documento: kp NO se puede inferir del duty
    de equilibrio. En equilibrio el error es cero y kp no interviene, asi que
    cualquier kp lleva al mismo duty final -- solo cambia cuanto tarda y si oscila.
    kp se calcula como alfa/K a partir de la medicion en lazo abierto, porque
    kp*error es un paso de duty y por lo tanto kp tiene unidades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
2026-09-09 Deriva el sampleTime del regulador del intervalo real de medicion
    FieldController::Config tenia sampleTime en 0.2s mientras update() se llamaba
    cada 500ms: el termino integral corria escalado a menos de la mitad de lo
    configurado. No era un descuido dificil de ver sino uno imposible de ver --
    las dos constantes viven en archivos distintos y ninguna referenciaba a la
    otra, asi que nada podia delatar la diferencia.
    makeFieldControllerConfig() lo deriva del intervalo que se le pasa, y el .ino
    le pasa Intervals::MeasureMagneticField. Con eso el valor tiene una sola
    fuente de verdad: cambiar la cadencia de medicion reajusta el regulador solo.
    El default de 0.2s queda unicamente para los Config q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
2026-09-09 Reparte la intensidad en un canal por bobina
    Engine escribia a un unico PwmDriver: una sola bobina, una sola intensidad.
    CoilChannel es ahora el dueño de las dos señales que son 1:1 con una bobina
    -- su PWM y su enable -- y CoilChannels agrupa las cuatro para que las
    operaciones del experimento sigan siendo una linea en Engine.
    El lazo sigue siendo UNO. Con un solo magnetometro no hay realimentacion por
    bobina, asi que la "intensidad individual" no son cuatro lazos: es un duty
    comun que cada canal escala por su factor de calibracion. Las diferencias
    entre bobinas viven en esos factores, medidos en banco, y no en el control.
    El factor arranca en 1.0, que significa "todavia sin medir" y no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
2026-09-09 Alterna los grupos de fase y deja BOB1 y BOB2 activas por defecto
    Los grupos de fase pasan a ser alternados: bobinas 1 y 3 en el grupo fijo, 2 y
    4 en el invertible, en vez de los pares contiguos 1-2 y 3-4 que se venian
    asumiendo.
    El motivo es que con pares contiguos, cualquier par de bobinas consecutivas cae
    en el mismo grupo -- y con solo dos montadas el campo nulo no se puede
    verificar, porque no hay nada que cancelar. Alternando, BOB1 y BOB2 quedan en
    grupos opuestos y los dos modos de experimento se pueden ejercitar desde el
    primer par que se cablee, sin esperar a tener las cuatro.
    Por eso el default pasa a ser BOB1 + BOB2 registradas y las otras dos
    comentadas, mismo patron de bring-u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
2026-09-09 Lee los menus e intervalos de la ESP32 desde la tarjeta SD
    Primera fase de la parametrizacion: ConfigLoader lee /biosoft/config.json y
    pisa con el las opciones de los menus y los intervalos de la ESP32, que hasta
    ahora eran constantes de compilacion.
    Los defaults compilados no desaparecen: el archivo solo pisa las claves que
    trae. Sin tarjeta, sin archivo, con JSON corrupto o con una schemaVersion que
    no se entiende, el sistema arranca con los valores del firmware. Por eso
    load() no devuelve "fallo" sino "aplique algo": el llamador no tiene nada
    distinto que hacer en cada caso, y el arranque nunca se bloquea por
    configuracion.
    Un JSON que no parsea se descarta entero y no a medias -- aplic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
2026-09-09 Envia intervals.mega, control y coils al Mega por primera vez desde la SD
    Hasta ahora ConfigLoader solo aplicaba menus e intervalos locales de la
    ESP32; el Mega no recibia nada del archivo de configuracion. Se agrega
    el mecanismo de envio fragmentado con ack/reintento que el esquema ya
    definia (config_intervals/config_control/config_coil), generalizado a
    un solo Tasks::ReSendConfig en vez de una tarea por frame. FieldController
    y CoilChannels ganan setters para poder aplicar calibracion despues de
    construidos, ya que antes solo se fijaban en el .ino al arrancar.
2026-09-09 Configura las fuentes del Detector desde la SD y retira el combo testMode
    Las reglas que deciden cuando se corta un experimento eran literales en
    detectorconfigbuilder.hpp, y las de CEM1 son placeholders sin calibrar: se
    ajustaban recompilando, que es justo lo que no sirve en laboratorio. Ahora
    llegan por config_source/config_rule y el Mega valida cada regla entera
    contra los topes del esquema, descartandola si algo cae fuera de rango.
    El testMode se retira porque sus tres ejes ya viven en el archivo: sensor y
    enabled quedaron en detector.sources, y el modo "solo sensado" en
    control.enabled. Tenerlos duplicados dejaba dos autoridades decidiendo lo
    mismo en cada start.
    test_serialframes fij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
2026-09-09 Parametriza la telemetria remota desde la SD
    El topic, los nombres de las 6 claves y las dos cadencias de publicacion
    eran constantes: cambiar cualquiera obligaba a reflashear, justo del lado
    que tiene que coordinarse con el Decoder de Datacake. Ahora salen de la
    seccion telemetry del archivo, con los mismos valores como defaults
    compilados.
    De paso se cierra el mismo agujero que aparecio en el protocolo serie:
    _publishTelemetry ya no ignora el retorno de serializeJson. Con los nombres
    configurables, un par largos alcanzan para pasarse de los 128 bytes del
    buffer, y un JSON recortado no lo parsea el Decoder -- se perderia la tanda
    entera sin aviso. Se prefiere no publicar y dejarlo en el lo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
2026-09-09 Configura los canales de corriente desde la SD y protege el bus I2C
    Ultima seccion del esquema. Los parametros del sensor estaban fijos en el
    .ino y solo habia un canal instanciado; ahora los 4 slots se declaran
    estaticos y el archivo decide cuales se habilitan.
    El esquema decia que el ADS1115 tenia canales 0 a 3. No los tiene: son 2
    pares diferenciales, y un canal 2 o 3 caia en el default de readRaw()
    devolviendo 0, o sea un sensor que mide 0 A para siempre pareciendo sano.
    Los 4 canales del gabinete necesitan dos modulos, asi que cada entrada se
    identifica ahora por (address, channel).
    El segundo modulo se declara aunque todavia no exista fisicamente: agregarlo
    mas adelante tiene que ser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
2026-09-10 Envia el modo de experimento en el comando start
    El Mega ya aceptaba el parametro `mode` del comando start desde que existe
    CoilExcitation (campo X / campo nulo, un GPIO al mux analogico), con sus
    tests, pero la ESP32 nunca lo mandaba: el campo nulo del grupo control era
    inalcanzable desde la pantalla.
    Se agrega todo lo que no es el widget:
    - `ConfigurationOptions::optionsFieldMode` / `countFieldMode`, fijo en 2 y
    deliberadamente NO parametrizable desde la SD. Son una condicion
    experimental del diseño, no numeros a calibrar; dejarlo en el archivo
    permitiria borrar "Campo nulo" de la lista y volver el grupo control
    inalcanzable sin sintoma.
    - `ConfigurationData::fieldModeOption`, d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
2026-09-10 Documenta por que el menu de modo no sale de la tarjeta SD
    La seccion de esp32 de CLAUDE.md dice que ConfigurationOptions se puebla
    desde el archivo de la SD, asi que quien lea la nueva optionsFieldMode va
    a asumir lo mismo y en algun momento la va a mover al esquema. Queda
    escrito por que no: campo X y campo nulo son una condicion experimental
    fija del diseno, y dejarla en el archivo permitiria borrar "Campo nulo"
    de la lista y volver el grupo control inalcanzable sin sintoma. De ahi
    tambien que su `value` sea un const char* mientras el resto de los menus
    copian sus strings.
2026-09-10 Agrega la app externa que genera el config.json de la SD
    Tarjeta 13. La plataforma elegida es un unico HTML autocontenido, sin
    build, sin dependencias y sin CDN: se abre con doble clic en cualquier
    maquina y funciona offline. Las alternativas (script de Python, app de
    escritorio) pedian toolchain y una historia de distribucion para lo que
    en el fondo es un formulario que escribe un JSON.
    Cubre las 6 secciones del esquema, arranca de los mismos defaults que
    docs/config.example.json (un archivo generado sin tocar nada no cambia el
    comportamiento del equipo), permite cargar un config.json existente para
    editarlo y muestra el archivo resultante antes de descargarlo.
    La validacion esta partida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
2026-09-10 Actualiza el protocolo de calibracion y agrega el manual de usuario
    El protocolo de calibracion ya existia pero habia envejecido mal: su
    prerrequisito numero uno era corregir sampleTime a mano, cosa que ya no
    hace falta porque makeFieldControllerConfig() lo deriva de
    intervals.mega.measureMagneticField; hablaba de CoilChannel "cuando
    exista"; y daba por futuro el archivo de configuracion en SD, que hoy es
    por donde entran todos los valores que el protocolo produce. Queda
    actualizado, con la configuracion de partida escrita en JSON y las trazas
    concretas del monitor serie donde se leen campo, duty y saturacion.
    Se agrega ademas lo que faltaba: deadBand (el esquema lo tiene y el
    protocolo lo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
2026-09-10 Publica el manual de usuario en HTML y PDF
    El manual pasa de Markdown a un HTML con diseno propio, pensado para los
    dos destinos a la vez: lectura en pantalla y PDF impreso. Serif para el
    cuerpo y sans para titulos, indice lateral fijo en pantalla, llamadas
    diferenciadas segun si algo es una explicacion, una advertencia o algo que
    hay que leer si o si antes de exponer animales.
    El PDF (17 paginas) se genera del HTML con Chrome headless, no se edita a
    mano; el comando queda en CLAUDE.md. El bloque @media print hace tres
    cosas que importan: portada en hoja propia, un indice impreso que la
    version de pantalla oculta, y salto de pagina antes de cada seccion,
    porque el manual se consulta saltead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
2026-09-11 Exporta el manual de usuario a Word
    Se pide poder editar el manual en Word antes de sacar el PDF. El .docx se
    genera escribiendo el OOXML a mano en vez de automatizar Word: manejar
    Word por COM devolvia RPC_E_CALL_REJECTED de forma persistente al guardar
    un HTML abierto --firma tipica de la Vista Protegida-- y ademas ataba la
    exportacion a tener Word instalado. Con la biblioteca estandar sola el
    script corre en cualquier lado.
    Dos cosas que el HTML no puede dar tal cual:
    - La jerarquia de titulos esta invertida para Word. En el manual el <h2>
    es la etiqueta chica ("Seccion 4") y el titulo real es un parrafo. Se ve
    bien en pantalla, pero el panel de navegacion y la tabla de contenido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
2026-09-11 Hace reproducible la exportacion a Word
    zipfile.writestr() con un nombre de entrada suelto estampa la hora actual
    en cada archivo del ZIP, asi que dos corridas del script sobre el mismo
    contenido daban .docx distintos byte a byte. Como el .docx esta versionado,
    eso significa que aparece modificado cada vez que alguien corre la
    exportacion, aunque el manual no haya cambiado: ensucia el diff y esconde
    los cambios que si importan, que en un binario ya son dificiles de ver.
    Se pasa a ZipInfo con fecha fija. Verificado: dos corridas seguidas dan el
    mismo SHA1.
2026-09-11 Corrige el pinout de la SD en la CYD y agrega el banco de pruebas del modulo SD
    La SD de la ESP32-2432S028 no comparte el bus SPI con el TFT: va por VSPI
    (SCK=18, MISO=19, MOSI=23, CS=5). SdStorage asumia 14/12/13 sobre HSPI y
    la tarjeta nunca contestaba ("sdSelectCard(): Select Failed"). Ademas una
    segunda SPIClass(HSPI) pisaba el periferico que TFT_eSPI ya usa.
    tools/test-sd-esp32 es el banco que lo detecto: proyecto PlatformIO
    independiente que ejercita el header real contra una tarjeta. Con los
    pines corregidos pasa 39/39, y de paso verifica que FILE_WRITE trunca y
    que readFile() rechaza el buffer justo en vez de truncar en silencio.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
    [main.cpp, sdstorage.hpp]
2026-09-11 El banco de SD muestra el config.json de la tarjeta
    Despues de las pruebas, y fuera del conteo, lee /biosoft/config.json con
    el mismo path y buffer de 8 KB que ConfigLoader y lo imprime entero por
    el monitor. Sirve para verificar que un archivo copiado a la SD llego bien
    sin tener lector en la PC.
2026-09-11 El banco de SD lista /biosoft cuando falta config.json
    Muestra nombre exacto y tamanio de cada entrada, porque la causa habitual
    es una extension oculta por Windows (config.json.json, config.txt) que el
    Explorador no deja ver.
2026-09-11 Soporta la placa JC2432W328C (ST7789 + CST816S) en la HMI
    La CYD original (ESP32-2432S028R) se daño y el reemplazo es una Guition
    JC2432W328C: mismo formato pero panel ST7789 con la inversion de color al
    reves y tactil capacitivo CST816S por I2C en los GPIO que la R usaba para
    el XPT2046. Con la config vieja los colores salian invertidos y el XPT2046
    leia un MISO flotante como un toque permanente en una esquina.
    - platformio.ini: TFT_INVERSION_ON (solo para la C).
    - display.hpp: selector TOUCH_KIND (Xpt2046 / Cst816s) y driver minimo del
    CST816S sobre Wire (5 registros, auto-sleep deshabilitado porque LVGL lo
    lee por polling), con rotacion a la orientacion 3 de la pantalla. El
    camino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
2026-09-22 Documenta el circuito de inversion de fase que resuelve la ADR-001
    La ADR decidia la inversion analogica pero dejaba abierto el op-amp, el
    multiplexor y la topologia. El esquematico completo vive ahora en
    docs/etapa-de-fase.html, autocontenido y que abre con doble clic como el
    manual y el generador: es la unica fuente del circuito, y la ADR y
    coil-excitation.md solo resumen las elecciones para no redibujarlo en
    dos lados y que se desincronicen.
    Queda asentado por que no sirven las alternativas obvias: el LM324/LM358
    distorsiona en el cruce a 5 V simple, el TL07x no es rail-to-rail con la
    entrada en 2,5 V, y un mux logico como el 74LS151 regenera niveles TTL
    en vez de dejar pasar la senoidal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
2026-09-22 Reescribe el manual de usuario sobre la interfaz nueva
    El manual describia las pantallas del diseno anterior, que ya no
    existen. Se reescribe siguiendo el recorrido real del operador y se
    agregan las secciones de cableado y de verificacion previa al encendido,
    que hasta ahora vivian solo en la cabeza de quien armo el gabinete.
    Los diagramas siguen siendo bloques de texto de caracteres de caja y no
    SVG: es lo unico que sobrevive igual al HTML, al PDF y a la exportacion
    a Word. El PDF y el .docx se regeneran de este HTML, que es la unica
    fuente.
2026-09-22 Rehace la interfaz sobre los exports nuevos y completa lo que mostraban a medias
    Las seis pantallas pasan a los exports de SquareLine UiFinalParte1 y
    UiFInalParte2, que renombran casi todos los widgets; Busy pasa a
    llamarse Esperando y desaparecen el cartel de cambios sin guardar, los
    chips de componentes y la columna de sensor de las bobinas. El repaso
    pantalla por pantalla que vino despues es lo que justifica el resto del
    commit: casi todo lo que se corrige aca mostraba un dato inventado con
    cara de medido.
    Lo que estaba mal y no se veia:
    - Principal mostraba los menus compilados y no los de la SD.
    updatePrincipalConfigurationLabels() corre en el constructor de
    SystemData, o sea en l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
    [SoftEsp32.ino, coilchannel.hpp, commands.hpp, configloader.hpp, engine.hpp, eventsname.hpp, intervals.hpp, mysystem.hpp]
2026-09-22 Reparte la telemetria en grupos y le da al monitor remoto lo que le faltaba
    Se publicaban 6 valores en un unico mensaje cada 30 s. Desde afuera no
    habia forma de saber por que termino un experimento, si estaba corriendo
    el grupo tratado o el de control, ni que alerta se habia levantado: todo
    eso existia en SystemData y se descartaba. Mandarlo junto no es una
    opcion, no entra en un mensaje, asi que va en 6 grupos y cada uno a su
    propio topic.
    Tres son periodicos y llevan su cadencia (measures, coils, status) y
    tres salen por evento (targets al arrancar, alerts con cada flag, result
    al cortar). Los de evento no aceptan intervalo: no significa nada para
    algo que ocurre una vez. Cada grupo se h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
2026-09-22 Muestra el estado de las cuatro conexiones en las tres pantallas
    El firmware ya sabia si estaba el enlace con el Mega, si habia WiFi y si
    respondia el broker -- los tres flags de CommunicationData se mantenian
    al dia desde sus callbacks -- pero no habia ningun widget que los
    mostrara: el rediseno se habia llevado los chips de componentes del
    diseno viejo y no dejo nada en su lugar. Los exports nuevos traen los
    iconos, asi que ahora se cablean.
    La SD es el caso distinto y suma un flag propio: la verdad la tiene
    SdStorage::isReady() y se lee UNA vez, en begin(). La libreria SD no
    notifica insercion ni extraccion, asi que sacar la tarjeta con la placa
    encendida deja el indicador en verde. Dete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
    [mysystem.hpp, screencontroller.hpp, systemdata.hpp]
2026-09-23 Crea y destruye las pantallas al navegar, en vez de tenerlas todas vivas
    Las seis pantallas se creaban en ui_init() y no se liberaban nunca,
    aunque se viera una sola. Con LV_USE_STDLIB_MALLOC en CLIB, LVGL sale
    del mismo heap que mbedTLS, y medido en placa esas seis se llevan ~176
    KB: quedan 77 KB libres con un bloque contiguo maximo de 45 KB.
    mbedtls_ssl_setup() pide dos buffers de ~16,7 KB mas el handshake, asi
    que TODA conexion al broker moria con -32512 SSL_ALLOC_FAILED. Los
    tamanos de esos buffers estan fijos en el SDK precompilado del core.
    Ahora cada pantalla se crea al mostrarse y se destruye al salir, por
    grupos: Principal y Configuraciones viven juntas porque se va y se
    vuelve ent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
    [SoftEsp32.ino, broker.hpp, configloader.hpp, iscreen.hpp, mysystem.hpp, screencontroller.hpp, screenmanager.hpp]
2026-09-23 Arranca el monitor web: plan de trabajo y andamiaje de la fase 0
    El ESP32 ya publica toda la telemetria al broker; lo que falta es todo lo que
    vive del otro lado. docs/plan-monitor-web.md fija el contrato de entrada leido
    de topics.hpp y _publish*(), el modelo de datos en Mongo y las 8 fases.
    Tres cosas del contrato condicionan el diseno y quedan escritas ahi porque no
    se deducen del codigo del backend: ningun payload trae timestamp (lo pone el
    ingestor), cinco de los seis grupos van con retain -- asi que el broker
    reentrega el ultimo de cada uno en cada reconexion, y tratarlos como eventos
    nuevos haria que cada reinicio abriera un experimento fantasma y cerrara el que
    esta corriendo -- y l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
2026-09-23 Guarda la telemetria en Mongo: modelos, parseo e ingesta (fase 1)
    Las tres series (measures, coils, statuses) son time-series collections y
    alerts una coleccion normal. El unico camino de escritura es el handler:
    parsea, guarda, y recien despues emite por Socket.IO el mismo objeto que
    guardo, asi el tablero no puede mostrar una medicion que no quedo registrada.
    Si Mongo esta caido no guarda y por lo tanto tampoco emite.
    El parseo acepta lo parcial y descarta lo que no tiene nada aprovechable,
    porque la SD puede deshabilitar campos uno por uno y coils trae solo las
    bobinas que existen -- el largo de ese arreglo es informacion, cuatro
    posiciones fijas no distinguirian una bobina ausente de un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
2026-09-23 Agrupa la telemetria en corridas: apertura, cierre y huerfanas (fase 2)
    La placa no manda un id de experimento: publica targets al entrar en Running y
    result al cortar, y en el medio muestras sueltas. Que esas muestras pertenezcan
    a un experimento es una inferencia, y es lo unico que convierte un flujo de
    numeros en un historico consultable.
    targets abre la corrida, result la cierra, y cada muestra se guarda ya con su
    runId -- las time-series collections no se actualizan despues, pero no hace
    falta: targets siempre llega antes que la primera muestra.
    Los casos que no son el feliz, que son los que importan:
    - Una corrida que quedo sin cierre se marca huerfana con la fecha de su ULTIMO
    DA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
2026-09-23 Da estado completo al conectar y arma la pantalla En curso (fase 3)
    Lo primero que recibe un cliente por WebSocket es un snapshot con todo el
    estado: la corrida abierta con sus objetivos, la ultima medicion, las bobinas,
    el progreso y las alertas de esa corrida. Es lo que le devuelve al navegador el
    beneficio del retain del broker, que se perdia porque el navegador no habla
    MQTT -- y mejor, porque sale de lo que quedo guardado y no de lo ultimo que el
    broker tenga en memoria. Sin esto, una pantalla recien abierta se queda en
    guiones hasta la proxima tanda: con el intervalo por defecto, medio minuto
    mirando una pantalla vacia durante un experimento que corre perfecto. Tambien
    esta como GET /a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
2026-09-23 Abre el historico: API de corridas, lista y detalle con graficos (fase 4)
    La API devuelve la lista paginada con filtros por modo, motivo y fecha; el
    detalle de una corrida; las series agregadas; las alertas; y un CSV.
    El modo y el motivo van en la LISTA, no solo en el detalle: recorrer el
    historico es casi siempre buscar que corridas fueron control y cuales se
    cortaron solas, y tener que abrir cada una para saberlo la volveria inservible.
    Las series se agregan por bucket en la base, con el tamaño elegido segun la
    duracion de la corrida para no pasar de 500 puntos. Cada punto lleva promedio,
    MINIMO Y MAXIMO: promediar esconde justamente el pico que disparo la alerta,
    que es lo que alguien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
2026-09-23 Cierra el monitor detras de un login (fase 5)
    Login con JWT y contraseñas con scrypt, que viene en Node: una dependencia
    nativa menos que compilar en el contenedor del despliegue. El hash guarda sus
    parametros adentro, asi que subir el costo mas adelante no invalida los hashes
    viejos.
    Se cierra TODO, y el WebSocket tambien: es la otra puerta al mismo dato, y
    cerrar solo las rutas HTTP dejaria la telemetria en vivo accesible a cualquiera
    que abriera un socket. /api/health tambien queda detras del token, porque dice
    la URL del broker y el clientId. Lo unico publico es /api/ping, para que un
    chequeo de disponibilidad no necesite credenciales.
    Cuatro decisiones que son de seguridad y no se ve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
2026-09-23 Empaqueta el monitor para la nube (fase 6)
    Un solo contenedor: el backend sirve tambien el front compilado, desde el mismo
    origen. Asi no hay CORS que configurar, el token viaja sin preflight, y cambiar
    de dominio no obliga a recompilar el front con una URL adentro del bundle.
    Dos cosas del front que sin esto fallan recien en produccion: las rutas reales
    (/historial, /corrida/:id) necesitan que el servidor devuelva el index para
    todo lo que no sea /api, o recargar la pagina o compartir un link da 404; y el
    index.html no se cachea aunque los assets si, porque un index viejo en el cache
    serviria la version anterior de la app entera aunque el despliegue haya salido
    bien.
    En produccion el arra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
2026-09-23 Agrega un asistente que arma el despliegue (sin ejecutarlo)
    tools/generador-despliegue.html: se abre con doble clic, sin build, sin
    dependencias y sin internet, igual que tools/generador-config.html. Se
    completan los campos y da el archivo biosoft.env y los comandos exactos.
    No ejecuta nada, y no puede: el navegador no deja que una pagina corra comandos
    en la maquina, lo cual esta bien -- si pudiera, cualquier sitio podria hacerlo.
    Entrega los secretos en un ARCHIVO y no en un comando con los valores adentro:
    `fly secrets import < biosoft.env` lee de la entrada estandar, asi que una
    contraseña con $, ", ' o ! no rompe nada ni queda en el historial de la
    terminal. Un `fly secrets set VAR="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
2026-09-23 Corrige el runbook para importar los secretos desde el archivo
    La seccion 4 seguia mostrando `fly secrets set` con los valores adentro, que es
    exactamente lo que el asistente evita: una contraseña con $, ", ' o ! la
    interpreta el shell antes de que llegue a fly, y en el peor caso guarda un
    valor distinto del que se escribio, sin dar ningun error.
2026-09-23 Aclara en el generador que el usuario inicial es el del dashboard
    El campo decia "Usuario inicial" sin explicar de que, y se presta a pensar que
    es el de Atlas o el del broker. Ahora dice que es con el que se entra al
    dashboard, que lo elige quien despliega, que solo se crea si la base no tiene
    ningun usuario, y que conviene cambiarlo apenas se entra porque queda escrito
    en las variables de entorno de la plataforma.
2026-09-23 Restaura fly.toml despues de que fly launch lo pisara
    `fly launch` reescribe el archivo con sus defaults y borro justo lo que
    importa: auto_stop_machines paso a 'stop' y min_machines_running a 0, con lo
    cual la maquina se apaga cuando nadie visita el sitio -- y este servicio es el
    unico cliente MQTT que escucha la placa, asi que apagado pierde telemetria que
    no se recupera. Tambien saco el health check y subio la memoria a 1 GB.
    Queda anotado arriba del archivo para que no sorprenda la proxima vez. La
    region se cambia a gru: el cluster de Atlas quedo en sa-east-1 (Sao Paulo) y
    cada muestra es una escritura a la base.
2026-09-23 Hace que el archivo de secretos sea el que flyctl acepta
    `flyctl secrets import` rechaza el archivo ENTERO si encuentra una linea que no
    sea NOMBRE=VALOR: falla con "Secrets must be provided as NAME=VALUE pairs" y no
    carga ninguna variable. El encabezado de comentario que el generador escribia
    para explicar que era el archivo alcanzaba para romperlo. Ahora salen solo las
    lineas de variables; lo que hay que saber esta en la pagina, no adentro del
    archivo.
    Ademas el comando ahora se da en las dos formas. PowerShell no soporta `<` para
    redirigir ("El operador '<' esta reservado para uso futuro"), asi que la
    variante de Windows es `Get-Content biosoft.env | flyctl secrets import` y la
    de bash q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
2026-09-23 Evita que un pedido con la base caida mate el servidor
    Encontrado en el primer despliegue real: con Mongo inalcanzable, cada intento
    de login terminaba el proceso. Express 4 no captura el rechazo de un handler
    asincronico, la promesa quedaba sin manejar y Node, por defecto, mata el
    proceso; como Fly lo reinicia, quedaba en un bucle de reinicios que desde
    afuera se ve como "la app no anda" y no dice en ningun lado que la causa era la
    base.
    Cuatro cambios, cada uno cubriendo una parte:
    - Los handlers asincronicos van envueltos, asi un rechazo se convierte en una
    respuesta de error y no en un proceso muerto.
    - Las rutas que consultan la base cortan con 503 cuando no hay conexion, en vez
    d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
2026-09-24 Arranca el broker y la base por separado
    El ingestor de MQTT arrancaba recien despues de que Mongo conectara, para
    reconstruir la corrida abierta antes de suscribirse. Eso ata una cosa a la
    otra: con la base caida el broker ni se intentaba, y el diagnostico decia
    "mqtt: false" sin que el broker tuviera nada malo -- que es exactamente lo que
    confundio en el primer despliegue. Y si la base se cayera con el broker sano,
    no habria ninguna razon para dejar de escuchar.
    El orden sigue garantizado donde importa: una muestra que llega sin base
    conectada se descarta en el handler, y la corrida abierta se recupera en cuanto
    Mongo responde.
    Se agrega tambien tools/probar-mongo.js, que prueba una URI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
2026-09-24 Permite simular contra el broker real sin meter la clave en la URL
    El simulador solo aceptaba la URL, asi que para apuntar al broker de
    produccion habia que embeber usuario y contraseña ahi adentro -- y cualquier
    @, / o # tiene que ir escapado. Una clave mal escapada no da error: el broker
    rechaza la conexion y parece que el host esta mal.
    Ahora van como --user y --pass.
2026-09-24 Convierte el PEM del broker cuando viene de una variable de entorno
    Un archivo .env no admite valores multilinea y ninguna plataforma deja pegar un
    certificado con saltos reales en un secreto, asi que el PEM viaja con los
    saltos escapados. El codigo lo pasaba tal cual a TLS, que lo rechaza por texto
    invalido -- con el MISMO error que si el certificado no estuviera cargado. Es
    decir: parecia que el secreto no habia llegado, cuando en realidad habia
    llegado mal.
    Aparecio desplegado, buscando por que el broker daba "unable to get local
    issuer certificate": el camino para arreglarlo estaba roto.
2026-09-24 Incorpora al asistente y al runbook lo aprendido desplegando
    Un despliegue real de punta a punta dejo una lista de cosas que ninguno de los
    dos documentos decia, y que cada una costo entre diez minutos y una hora. Ahora
    estan escritas donde se van a leer.
    En el asistente:
    - Los comandos usan `flyctl`, que es el nombre que deja el instalador de
    winget, no `fly`.
    - Avisa que `flyctl launch` REESCRIBE fly.toml con sus defaults y pisa
    auto_stop_machines=false y min_machines_running=1 -- con lo cual la maquina
    se apaga sola y el monitor deja de escuchar. Incluye el `git checkout` para
    restaurarlo.
    - La verificacion final mira los booleanos de /api/ping y no el 200: el
    servidor respond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
2026-09-24 Agrega la instalacion de flyctl al asistente y al runbook
    Faltaba el paso cero: los comandos arrancaban asumiendo la CLI instalada, y sin
    ella el primero falla con "command not found".
    Se aclara ademas que NO se instala con npm. El paquete llamado `fly` en el
    registro es una libreria sin ninguna relacion con Fly.io, y hay un `flyctl` que
    es un envoltorio de terceros: ninguno de los dos es la herramienta. Es un
    binario propio, se instala con winget en Windows o con el script oficial en
    macOS y Linux.
    Y que hay que cerrar y reabrir la terminal, porque el PATH nuevo no lo toma la
    que ya estaba abierta -- lo que hace parecer que la instalacion fallo.
    47 comprobaciones.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
2026-09-24 Lee el modo de campo como lo publica la placa, no como lo inventaba el simulador
    La placa publica MODE con el campo `value` de optionsFieldMode: "x" o "null".
    El front preguntaba `mode.includes('nulo')`, y "null" NO contiene "nulo": con
    datos reales, una corrida de CAMPO NULO se habria mostrado como campo X. Es
    decir, el grupo control indistinguible del tratado, que es justo la distincion
    que el experimento no puede perder y la unica que no se nota mirando la
    pantalla. Los filtros del Historial tampoco habrian coincidido nunca.
    La causa de que nadie lo viera es el simulador: mandaba la etiqueta ("campo X")
    en vez del valor, asi que reproducia un contrato que no existe. Ahora manda el
    valor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
2026-09-25 Documenta el monitor web en el manual, el README y la guia del repo
    El manual de usuario gana la seccion 13, "El monitor web": como se entra, que
    muestra cada pantalla y como se leen. Lo que un operador necesita saber para no
    malinterpretarla: que los valores se atenuan cuando envejecen (un numero
    atenuado es el ultimo dato conocido, no una medicion actual), que un valor
    ausente es "--" y nunca cero, que los graficos muestran minimo y maximo ademas
    del promedio, y que los tramos sin datos se dibujan como huecos porque unir los
    extremos afirmaria algo que nadie midio. Y el alcance: es de solo lectura por
    diseño, y si el monitor se apaga lo publicado se pierde.
    De paso, tres cosas del manual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
2026-09-25 Corrige el valor de MODE en el plan del monitor
    La tabla del contrato decia que MODE llega como el texto del menu ("campo X" /
    "campo nulo"). Llega como el valor: "x" o "null". Ese error de la
    documentacion es el que termino en el codigo -- el front preguntaba
    includes('nulo'), falso para "null", y una corrida de campo nulo se habria
    mostrado como campo X.
    docs/config-schema.md seccion 9 ya lo decia bien desde antes. Se anota que ese
    documento y topics.hpp son la autoridad sobre el contrato, y que esta tabla es
    un resumen.
2026-10-01 Marca las corridas de prueba para que no se mezclen con los experimentos
    Una corrida de banco y una con animales se veian identicas en el monitor:
    nada en la telemetria decia cual era cual, y el historico mezclaba datos de
    prueba con datos cientificos sin aviso.
    La tarjeta SD declara ahora runType ("normal" | "test"). No apaga ninguna
    proteccion -- cada relajacion sigue en su propia seccion --, solo marca: la
    placa manda TEST siempre (true o false) en targets y result, y en modo
    prueba muestra una franja MODO PRUEBA y un aviso de arranque en la capa
    superior de LVGL, que sobrevive a la destruccion de pantallas.
    El monitor guarda runType por corrida (normal / test / unknown) y no lista
    las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
2026-10-01 Permite apagar el detector, simular o quitar TEMP1 y exigir el Mega desde la SD
    Para trabajar en banco habia que recompilar: el detector no se podia apagar
    entero, TEMP1 solo aceptaba el DS18B20 (que bloquea 750 ms por medicion
    aunque no haya nadie en el bus) y el banco sin Mega dependia de una
    constante, BENCH_SIN_MEGA, que habia quedado en true en produccion.
    Ahora son tres claves de la tarjeta, todas con el valor restrictivo por
    defecto. detector.enabled apaga el Detector desde adentro (setEnabled), viaja
    en un frame propio y se aplica en el proximo start, como las fuentes, para
    no dejar sin vigilancia una corrida ya arrancada. TEMP1 acepta ds18b20, sim
    (A1, 0-5 V = 0-50 C) o none; un va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
2026-10-01 Genera lecturas sinteticas en el Mega para validar todo el proceso sin sensores
    Fabricar datos en el ESP32 solo probaba el envio, con alertas de mentira.
    Con sensor "scenario" el Mega calcula la lectura de CEM1 o TEMP1 y la pasa
    por la logica real: Detector, flags, corte, resultado, pantalla y monitor.
    Por serie viaja solo la definicion del escenario, una vez, en
    config_scenario.
    La senal se expresa en niveles relativos a los rangos de la corrida (0
    centro del normal, 1 borde del normal, 2 borde del critico), no en valores
    fijos: asi "temperatura alta" corta con cualquier rango elegido en
    pantalla. CEM1 tiene una planta simple para que el lazo regule de verdad.
    Con CEM1 sin sensor real (si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
2026-10-01 Corta el experimento cuando un sensor vigilado deja de dar lecturas
    El Detector solo evaluaba las muestras que llegaban: un DS18B20
    desconectado a mitad de corrida dejaba a los animales expuestos sin control
    de temperatura y la corrida terminaba como completed. Lo mostro el perfil
    "sensor caido" de los escenarios sinteticos.
    Ahora una fuente vigilada que pierde maxMissedSamples lecturas seguidas
    (default 3, piso de 5 s por el bloqueo del DS18B20) corta con una alerta
    "silence" por la misma via que un limite critico. El reloj corre desde el
    start y el corte se habilita al terminar la estabilizacion.
    CEM1 caido con el lazo activo corta siempre, vigilado o no y aun con el
    detector apagado: si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
2026-10-01 Registra con que configuracion y que relajaciones corrio cada experimento
    Para la trazabilidad cientifica hace falta poder decir, de cada corrida
    guardada, con que umbrales, factores y ganancias corrio. Y como cada
    parametro es configurable por separado, un experimento declarado normal
    podia tener protecciones apagadas sin que nada lo registrara.
    La placa publica en targets un id de configuracion (CRC32 del JSON leido
    sin wifi ni broker, o "default") y una mascara de relajaciones. El id lo
    calcula solo la placa: el monitor lo guarda y no lo recalcula, asi no hay
    dos implementaciones del mismo hash que puedan divergir.
    El monitor guarda las dos cosas y marca CON RELAJACIONES a un experiment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
    [configloader.hpp, mysystem.hpp]
2026-10-01 Permite editar la configuracion desde el monitor web y grabarla en la SD de la placa
    Hasta ahora cambiar un valor obligaba a sacar la tarjeta, editar el JSON y
    volver a meterla. La placa publica su configuracion vigente (sin wifi ni
    broker) en bloques retenidos y recibe la nueva de a un bloque por vez, con
    ack por bloque y reintentos, porque un mensaje MQTT entero no entra en el
    buffer. Antes de reemplazar la vigente la valida, la respalda en
    config.prev.json y restituye sus propias credenciales; se rechaza mientras
    hay un experimento en curso y se aplica en el proximo reinicio.
    El monitor embebe el generador de tools/ para tener una sola fuente de
    validacion, con un test que impide que la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
    [broker.hpp, configloader.hpp, mysystem.hpp, remoteconfig.hpp, sdstorage.hpp, tasks.hpp]
2026-10-01 Agrega mapa duty/campo, modo campo nulo y tara del campo ambiente configurable desde la SD
    El duty inicial sale de un mapa medido en banco en vez de buscarlo el controlador desde cero, y el campo nulo excita con la corriente mapeada contra un target de 0. Un start que no puede arrancar (sin punto, balance fuera de tope, tara rechazada) se muestra en Resultado como NO INICIO en lugar de correr degradado.
2026-10-01 Mide el campo como valor eficaz (RMS) y elimina la tara del ambiente
    Una lectura instantanea dependia de donde caia en la senal de 1 a 100 Hz, y el
    ambiente (continuo) podia ocupar toda la banda de tolerancia. El Mega ahora
    ajusta a*cos+b*sen+c por grupos de 10 muestras con su hora real: el termino
    constante es el ambiente y queda fuera, asi que la tara y control.tare sobran.
    A frecuencias altas las muestras se espacian con la razon aurea sobre varios
    periodos, porque con 3 por periodo el 2do armonico caia sobre la fundamental.
    La medicion no bloquea (una transaccion I2C por vuelta), el DS18B20 pasa a
    asincrono, Wire tiene timeout y la ventana del SCT013 se corta con el boton de
    emergencia: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
2026-10-02 Separa placa, enviado y edicion en el monitor y agrega ping a la placa
    Elegir un escenario no dejaba ver si se habia aplicado: los botones no
    marcaban nada, y despues mezclaban en el mismo lugar lo que corre en la
    placa con lo que se estaba editando. Ahora los botones marcan solo lo que
    se edita (el perfil se deduce de los valores, asi acierta tambien con un
    archivo cargado o editado a mano) y un bloque aparte muestra tres etapas:
    en la placa, enviado (grabado en la SD, esperando reinicio) y editando.
    La confirmacion de la placa ya existia pero quedaba en una lista fuera
    del generador; ahora se ve junto a Enviar y distingue grabada de vigente.
    Fuera de un experimento la placa no publica na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
2026-10-02 Permite configurar la direccion del DS18B20 desde la SD y agrega el checklist de puesta en marcha
    La direccion del termometro estaba fija en el .ino: montar otra unidad
    del mismo sensor dejaba a TEMP1 leyendo -127 y cortando cada corrida por
    silencio, sin nada que senalara la direccion como causa. Ahora es
    detector.sources[TEMP1].address, validada entera (familia y CRC) en el
    generador y en el Mega, que rechaza una mal copiada en vez de apuntar a
    un sensor inexistente. El Mega lista al arrancar los DS18B20 del bus para
    poder copiarla.
    En el generador, el campo address de los ADS1115 se convertia a numero
    por sufijo y habria dejado la direccion en 28; y cambiar el sensor no
    mostraba los camp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
2026-10-04 Pone en marcha el enlace serie con la placa JC2432W328C y saca al Mega del limite de RAM
    En la placa nueva el GPIO27 es la retroiluminacion y el 21 el INT del
    tactil, asi que el enlace pasa a RX 35 / TX 22 y TFT_BL a 27.
    Con el enlace andando aparecio que el Mega se colgaba al intercambiar
    tramas (heap y stack pisandose) y, despues, que armaba result_data y
    acks vacios por falta de memoria en el corte de un experimento. La cola
    de SerialLink ahora guarda bytes de tramas ya armadas en vez de copias
    de JsonDocument, no se guarda copia de los params recibidos, y el Mega
    achica tareas, nombres y pools. Una trama que no entra en 256 bytes se
    rechaza en vez de truncarse con CRC valido.
    Al dejar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
2026-10-04 Mejora el monitor remoto y estabiliza el enlace de la ESP32 con el broker
    El monitor se habia quedado corto para seguir una corrida desde afuera:
    graficos que se comprimian con cada muestra, alertas sin contexto, pruebas
    escondidas, y ninguna forma de gestionar cuentas ni de borrar corridas de
    banco. Ademas el firmware perdia telemetria y el broker se caia en plena
    corrida, y una corrida completa cerraba en 99%.
    Monitor:
    - Graficos en vivo en En curso con ventana deslizante por tiempo (el hueco
    de un corte se ve crecer en vez de disimularse) y layout a dos columnas.
    - Cada alerta en el grafico de su magnitud, a la altura de la ultima
    medicion, con su detalle al pasar por encima: regla,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
    [broker.hpp, mysystem.hpp, topics.hpp, wifimanager.hpp]
2026-10-05 Evita el bucle de reinicios del Mega cuando el MLX90393 no contesta
    begin_I2C() de Adafruit_MLX90393 2.0.5 no se puede llamar dos veces: usa
    un puntero ya liberado. Con el MLX ausente, el reintento de
    addMagnetometer() reiniciaba el Mega antes de Engine::begin(). Ahora
    begin() sondea la direccion primero, llama begin_I2C() una sola vez y
    reintenta con exitMode()/reset().
    [magnetometermanager.hpp, magnetometermlx90993.hpp]
2026-10-05 Fija el rele general y los enables de bobina como activos en alto
    HIGH energiza; LOW, pin al aire o Mega sin alimentacion dejan el rele
    abierto y las bobinas cortadas, con pull-down en la entrada de cada
    driver. mainRelay pasa de ACTIVE_LOW a ACTIVE_HIGH: un Mega apagado con
    la etapa alimentada cerraba un rele activo en bajo. La polaridad queda
    fija en firmware y especificada para el hardware, no configurable por SD.
    Se documenta en coil-excitation.md, el manual y el checklist de puesta
    en marcha (todos los enables en 0 V en una corrida sintetica).
    Tambien renombra la traza del lazo [TESTMODE][PWM] -> [CONTROL][PWM],
    herencia del testMode eliminado.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
